JJong-03/face-tracking-robot-arm/assets/presentations/final/20251117_2ndSem_12week_presentation_final-presentation-system-overview.pdf

01

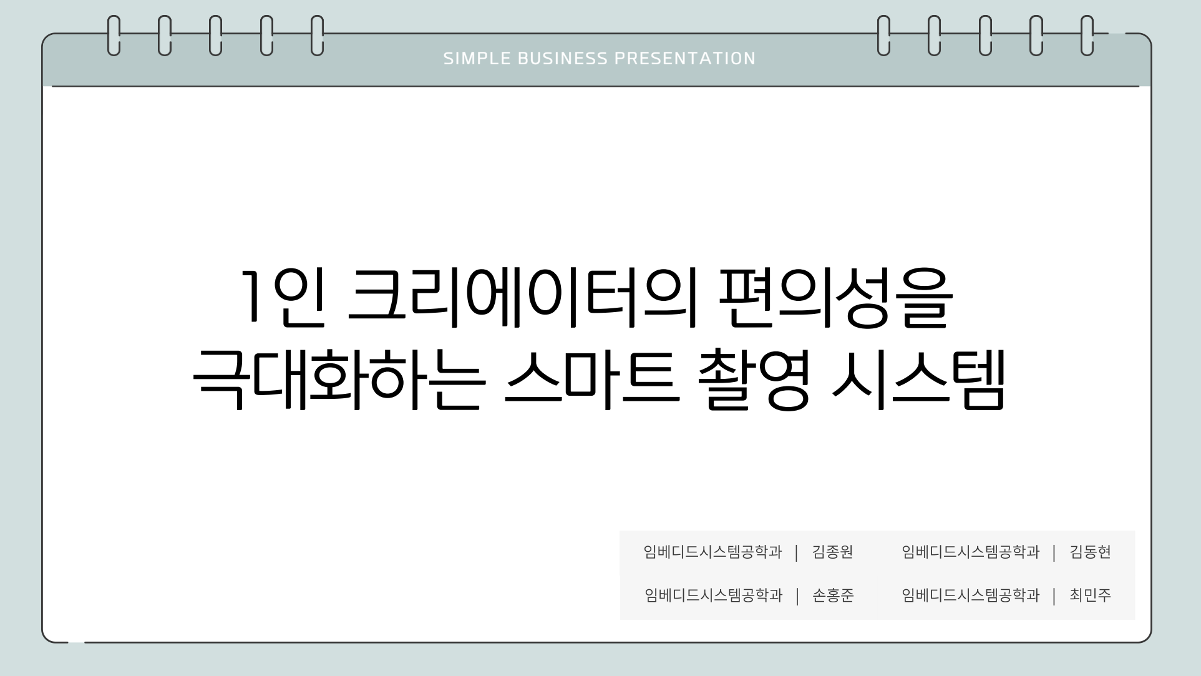
[picture p52: page 1]

임임임임임임임임임임 | | 임임임

# 1인 크리에이터의 편의성을 극대화하는 스마트 촬영 시스템

SIMPLE BUSINESS PRESENTATION

임임임임임임임임임임 | | 임임임
임임임임임임임임임임 | | 임임임 | 임임임임임임임임임임 | | 임임임

01

01

01 | 팀원 소개

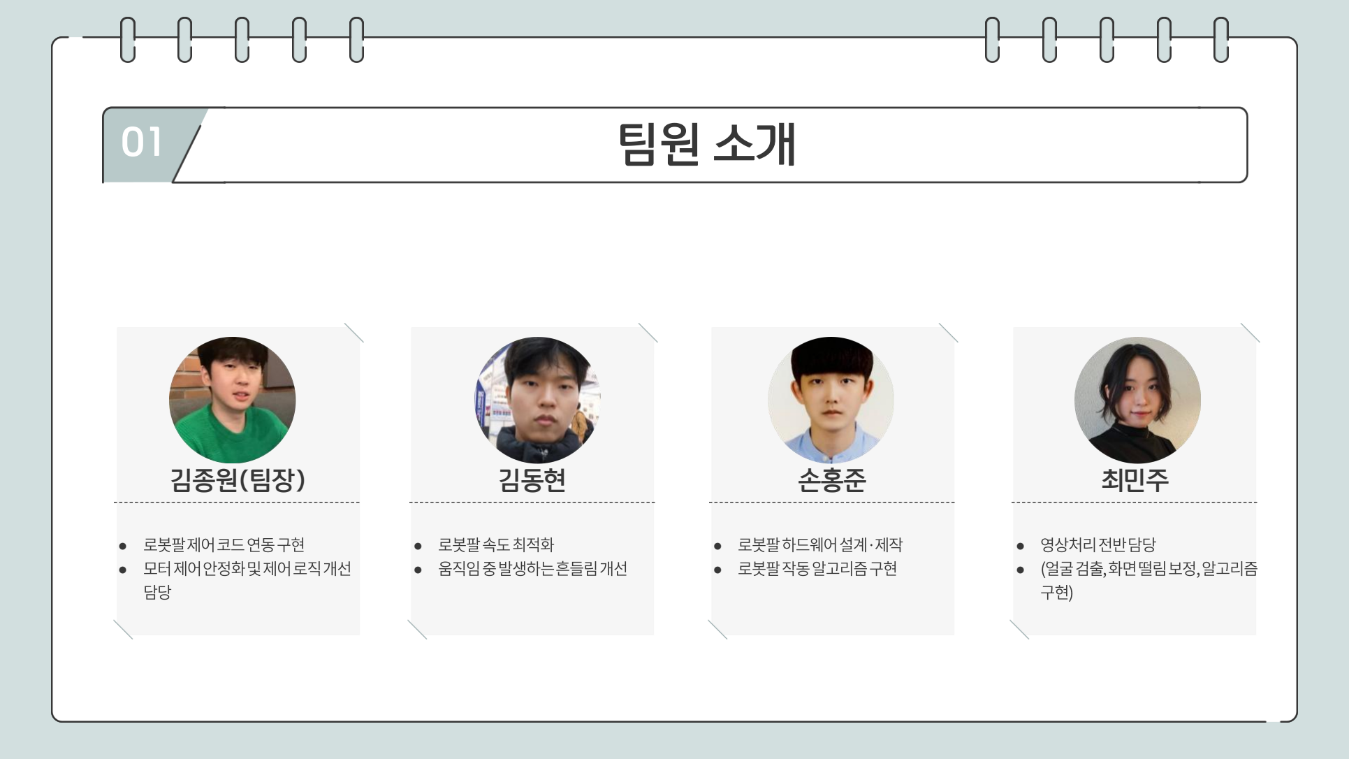
[picture p53: page 3]

- 임임임 | 임임 임임 임임 임임
- 임임 임임 임임임 | 임 임임 임임 임임
임임

## 김종원(팀장)

- 임임임 | 임임 임임임
- 임임임 | 임 임임임임 | 임임임 | 임임

## 김동현

- 임임임 | 임임임임 | 임임 · 임임
- 임임임 | 임임 임임임임 | 임임

## 손홍준

- 임임임임 임임 임임
- (임임 임임 , 임임 임임 임임 , 임임임임 임임 )

## 최민주

012 | 글로벌 크리에이터 경제 시장

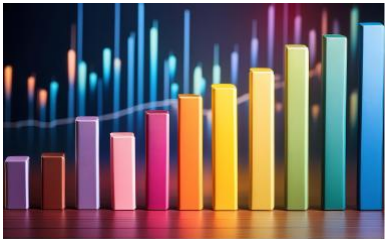
[picture p54: figure]
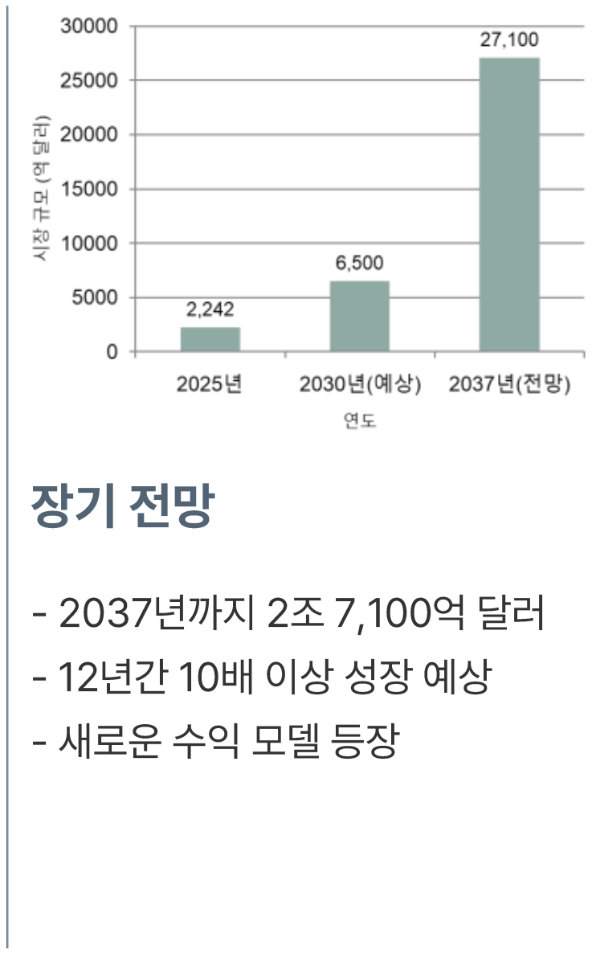
[picture p55: figure]
- 2037 임임임; - 임임임

- 임 2,242 임 임임
- 임임 임 268 임 임
- 임임임 | 임임임 | 임임

### 2025 임 임임 임임

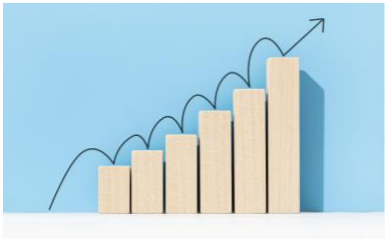
[picture p56: figure]

- 2024 임 임임 18.2% 임임
- 임임임임 | 임임임
- 임임임 | 임임임 | 임임 임임

### 임임임

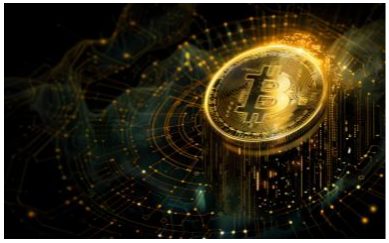
[picture p57: figure]

- CAGR 22.7%
- 임임 임임임 | 임임
- 임임임 | 임임 임임
- 임임 임임 임임

### 임임임 임임임

01

03 | Solution

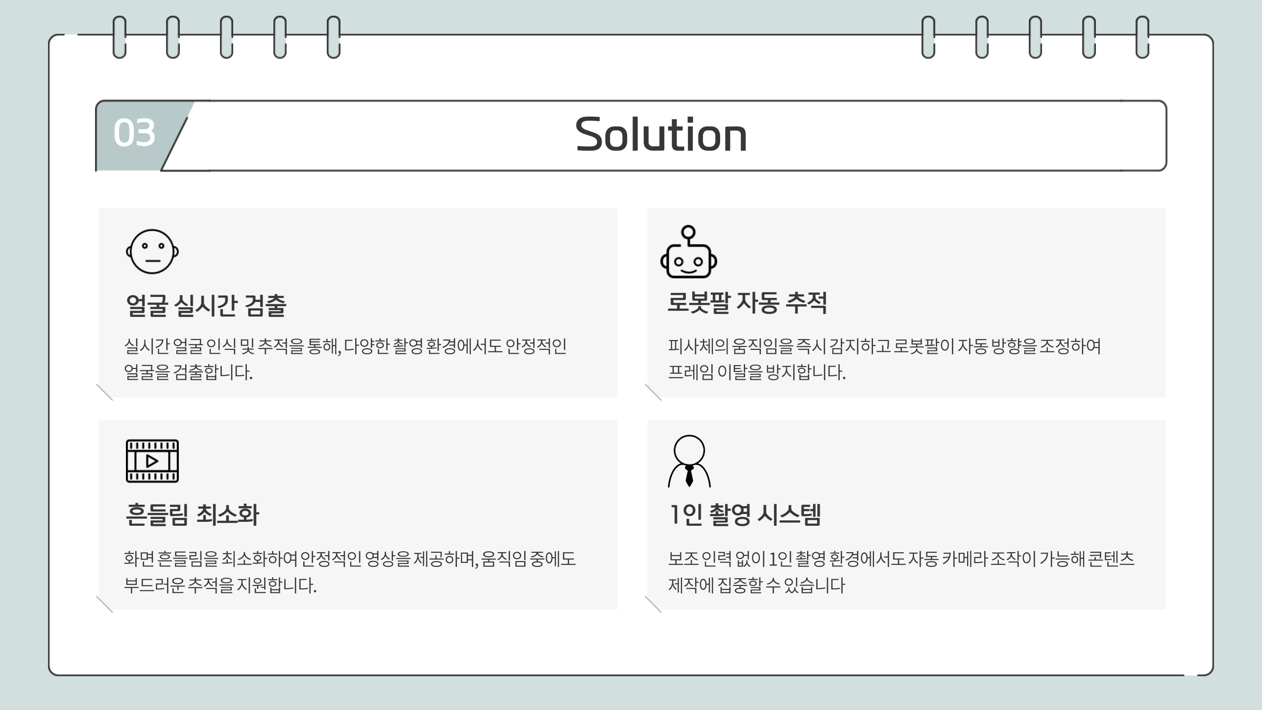
[picture p58: page 5]

임임 임임 임임 1임 임임 임임임임임 | 임임 임임임 | 임임임 | 임임임 | 임임임
임임임 | 임임임 | 임 임임임임

## 1인 촬영 시스템

임임 임임임임 | 임임임임임 | 임임임임 | 임임임 | 임임임임 | , 임임임 | 임임임
임임임임 | 임임임 | 임임임임임 | .

## 흔들림 최소화

임임임임 | 임임임임 | 임임 임임임임 | 임임임임 | 임임 임임임 | 임임임임
임임임 | 임임임 | 임임임임임 | .

## 로봇팔 자동 추적

임임임 | 임임 임임 임 임임임 | 임임 , 임임임 | 임임 임임임임임 | 임임임임
임임임 | 임임임임임 | .

## 얼굴 실시간 검출

04 | 기존의 제품과의 비교

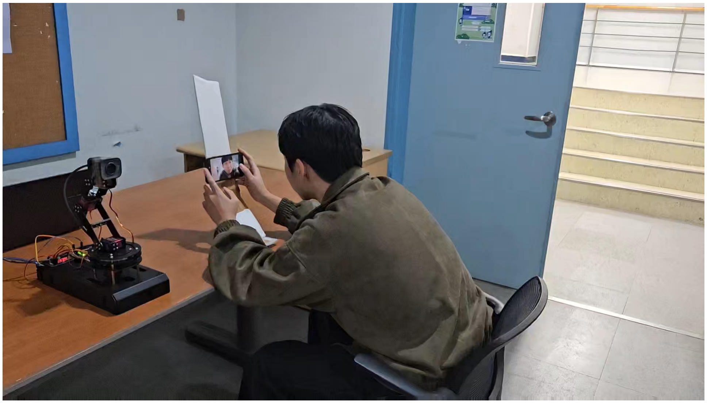
[picture p59: figure]

05 | 기존의 제품과의 비교

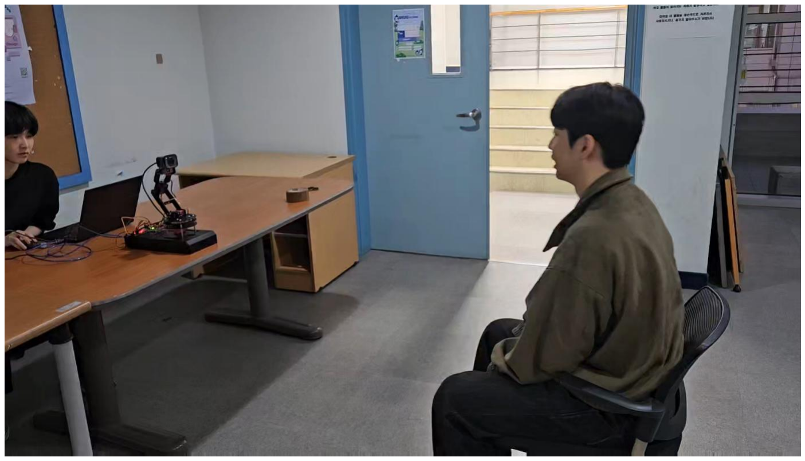
[picture p60: figure]
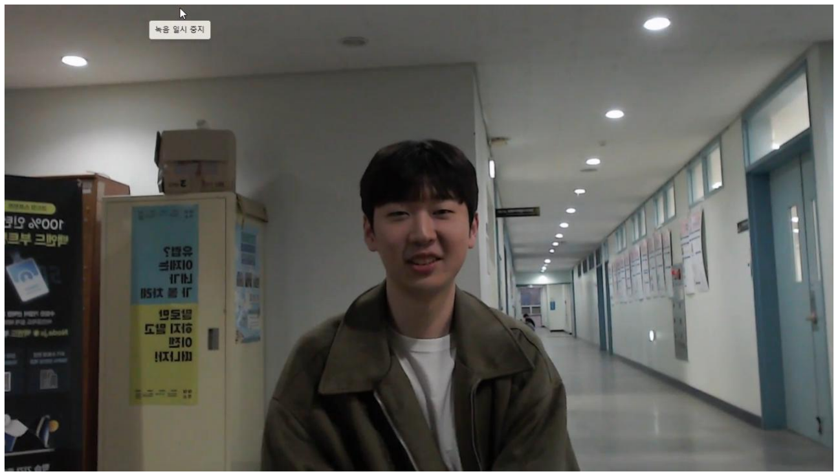
[picture p61: figure]

06 | 동작과정

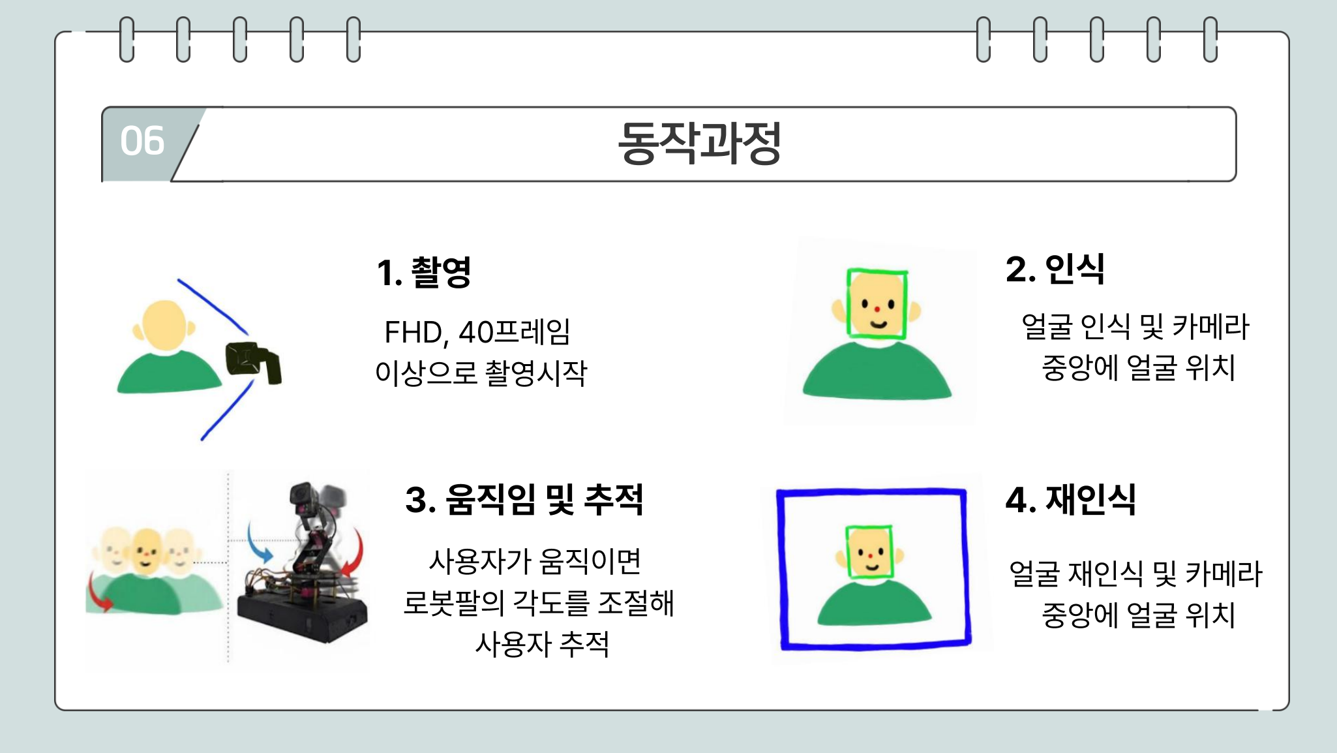
[picture p62: page 8]

1. 임임 | 2. 임임
3. 임임임 | 임 임임 | 4. 임임임

## FHD, 40 임임임 임임임임 임임임임

## 임임 임임 임 임임임

임임임 | 임임 임임
임임임임 | 임임임임
임임임임 | 임임임 | 임임임
임임임 | 임임
임임 임임임 | 임 임임임
임임임 | 임임 임임

07 | 기능 소개

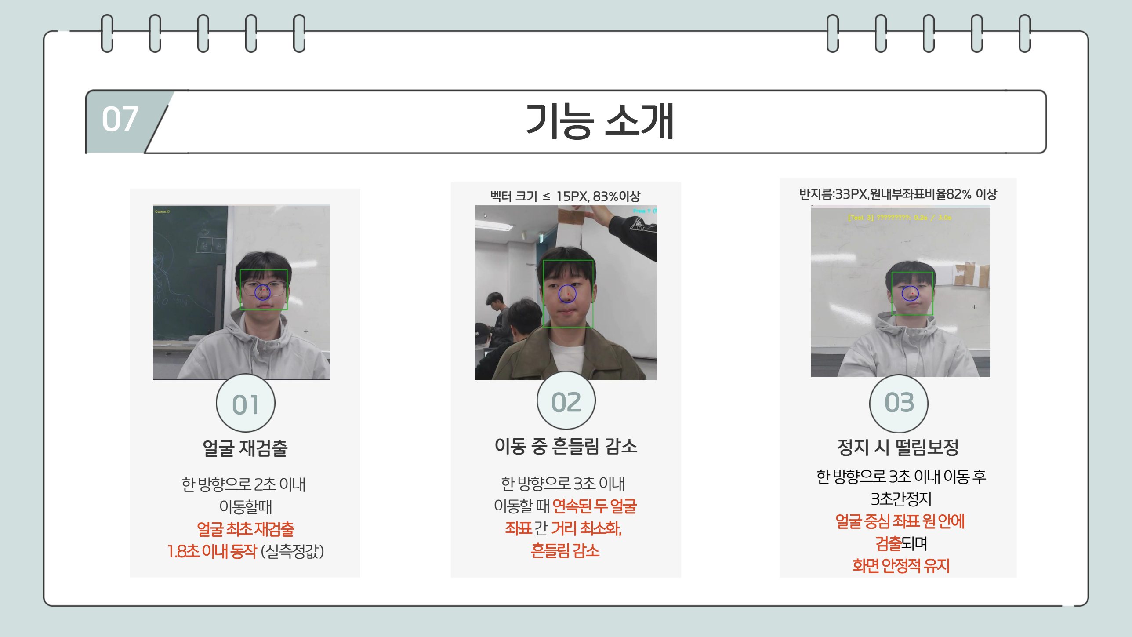
[picture p63: page 9]

한 방향으로3초 이내 이동 후
3초간정지
얼굴 중심 좌표 원 안에
검출되며
화면 안정적 유지

정지 시 떨림보정

한 방향으로3초 이내
이동할 때 연속된 두 얼굴
좌표간 거리 최소화,
흔들림 감소

이동 중 흔들림 감소

한 방향으로2초 이내
이동할때
얼굴 최초 재검출
1.8초 이내 동작(실측정값)

얼굴 재검출

벡터 크기 ≤ 15PX, 83%이상 | 반지름:33PX,원내부좌표비율82% 이상
01 | 02 | 03

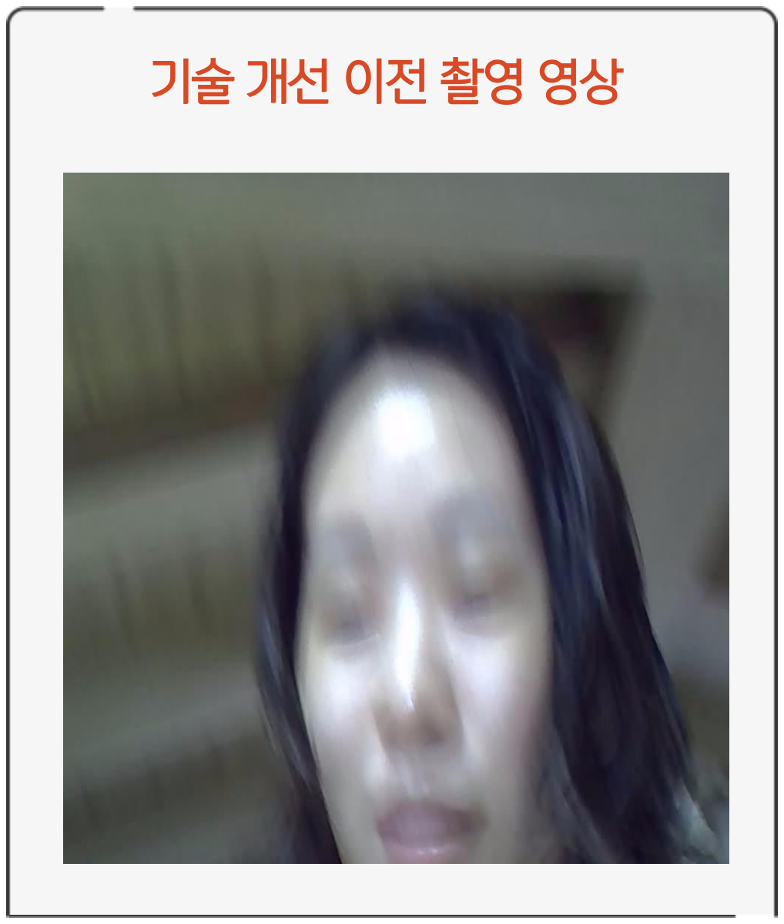
[picture p64: figure]

1. 하드웨어 구성

# 적용기술

SIMPLE BUSINESS PRESENTATION

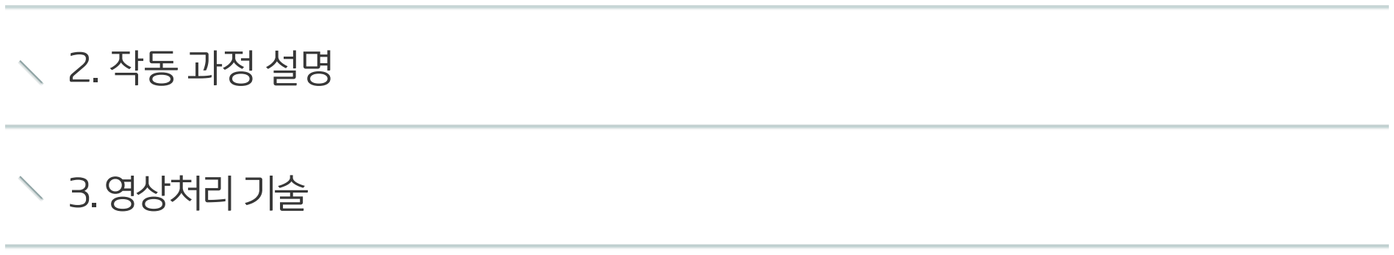
[picture p65: figure]
3. 영상처리 기술
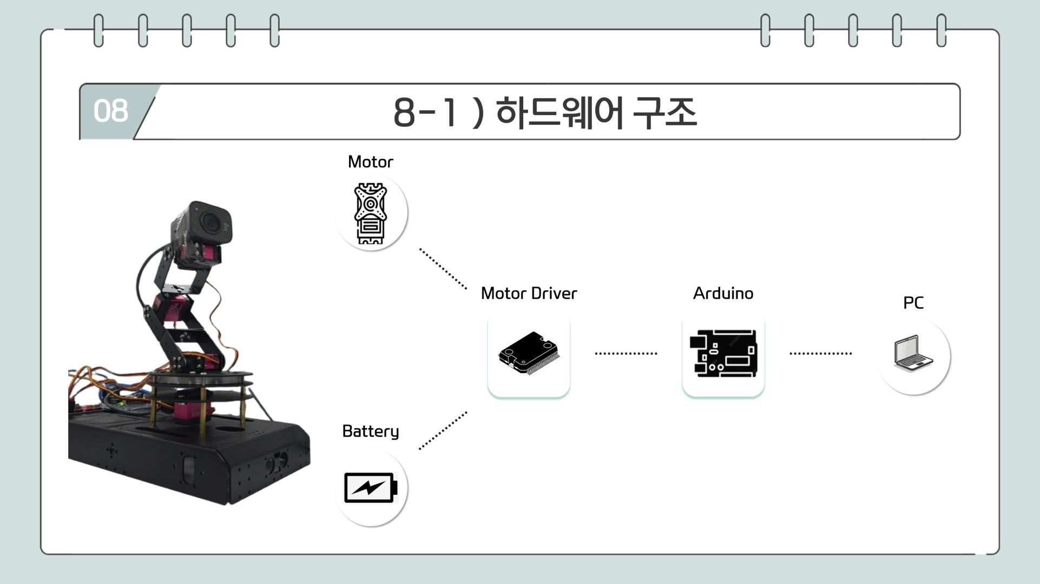
[picture p66: page 11]
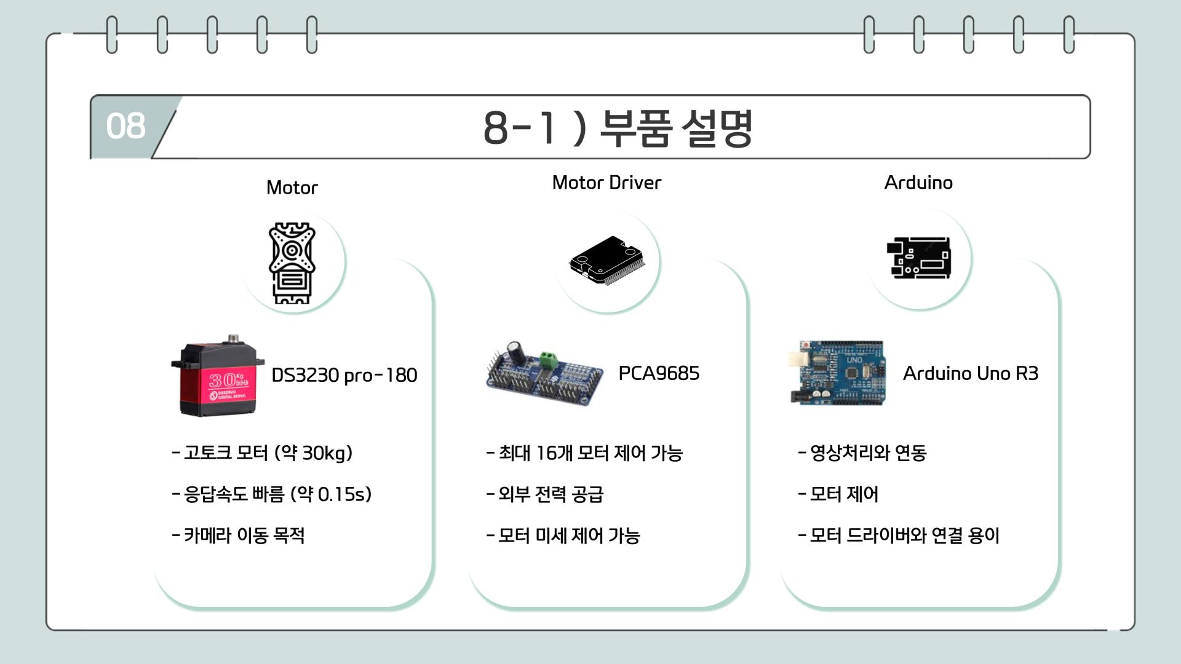
[picture p67: page 12]
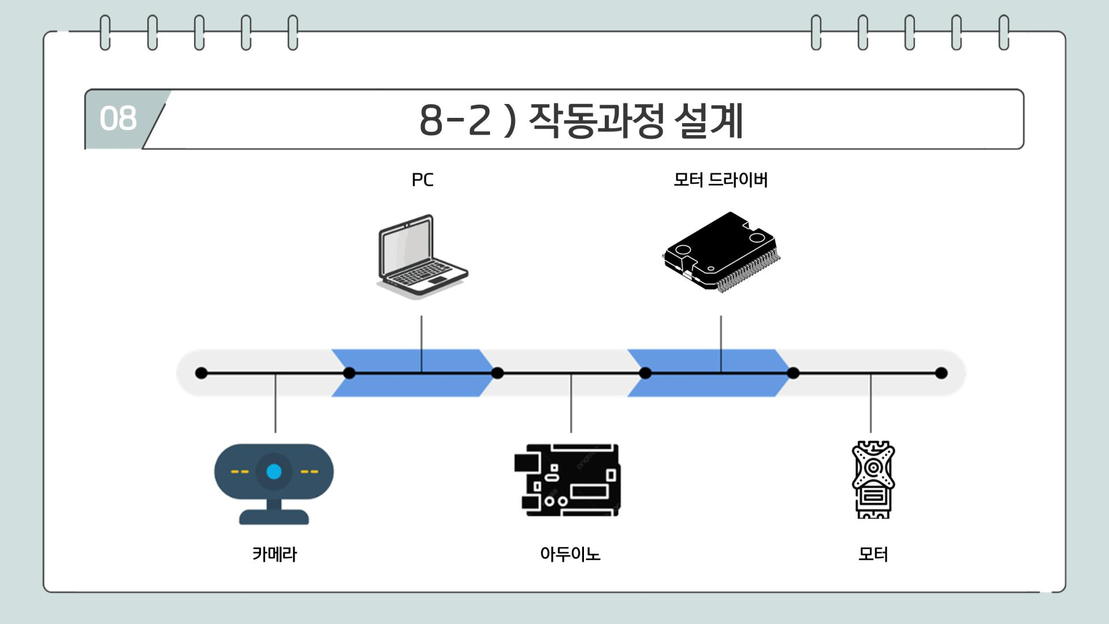
[picture p68: page 13]
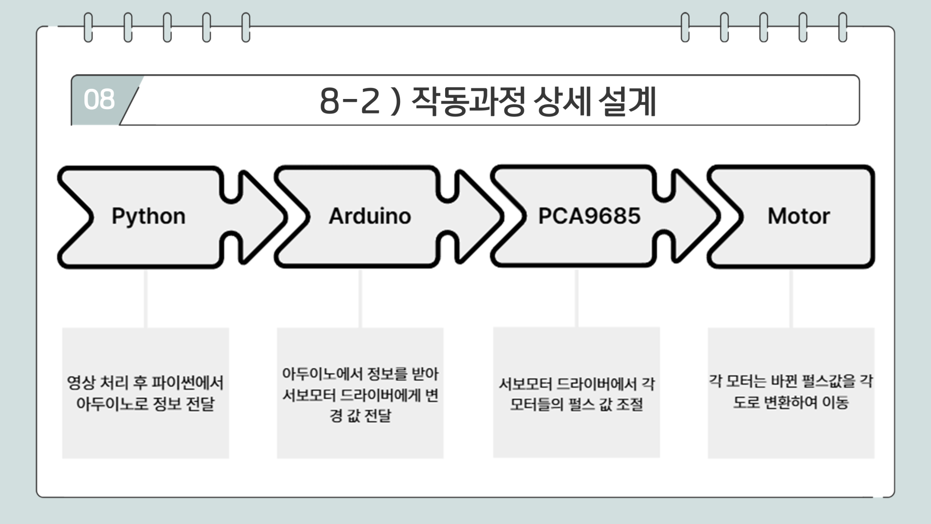
[picture p69: page 14]
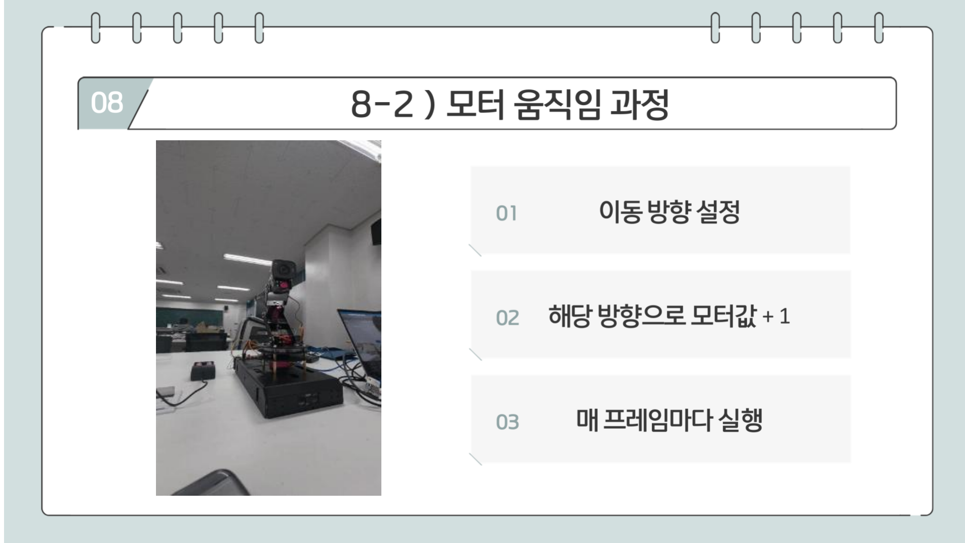
[picture p70: page 15]

08 | 8-3) 영상처리

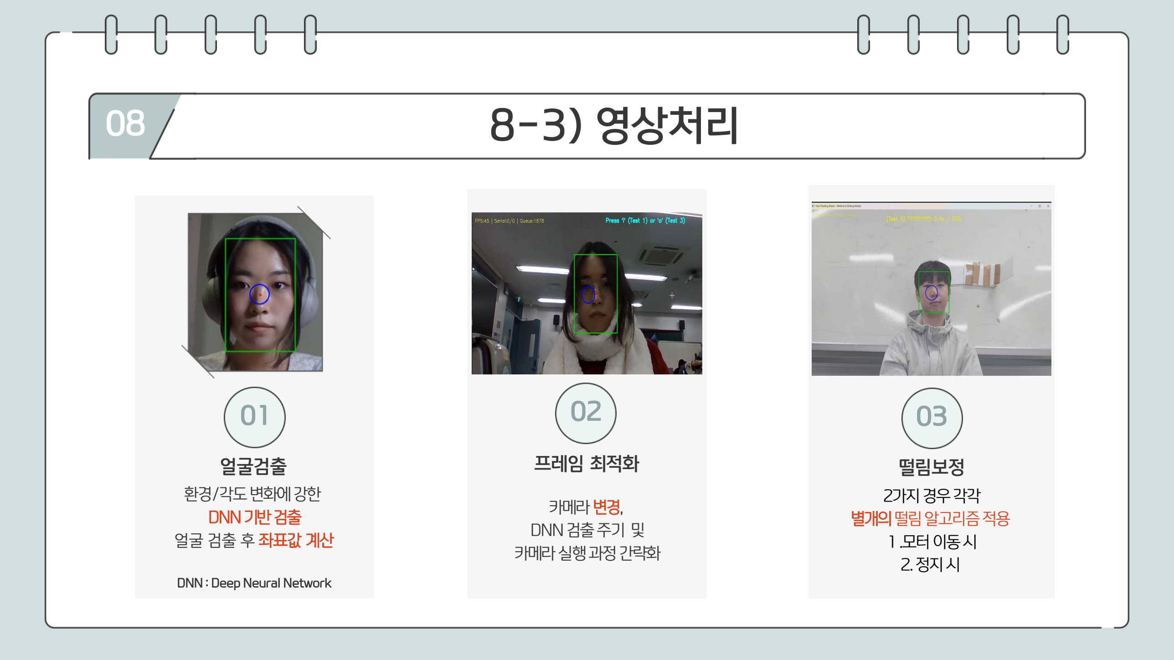
[picture p71: page 16]

2가지 경우 각각
별개의떨림 알고리즘 적용
1 .모터 이동 시
2. 정지 시

떨림보정

03

카메라 변경,
DNN 검출 주기 및
카메라 실행 과정 간략화

프레임 최적화

02

환경/각도 변화에 강한
DNN 기반 검출
얼굴 검출 후 좌표값 계산

DNN : Deep Neural Network

얼굴검출

01

09 | 시스템 도입 효과 요약

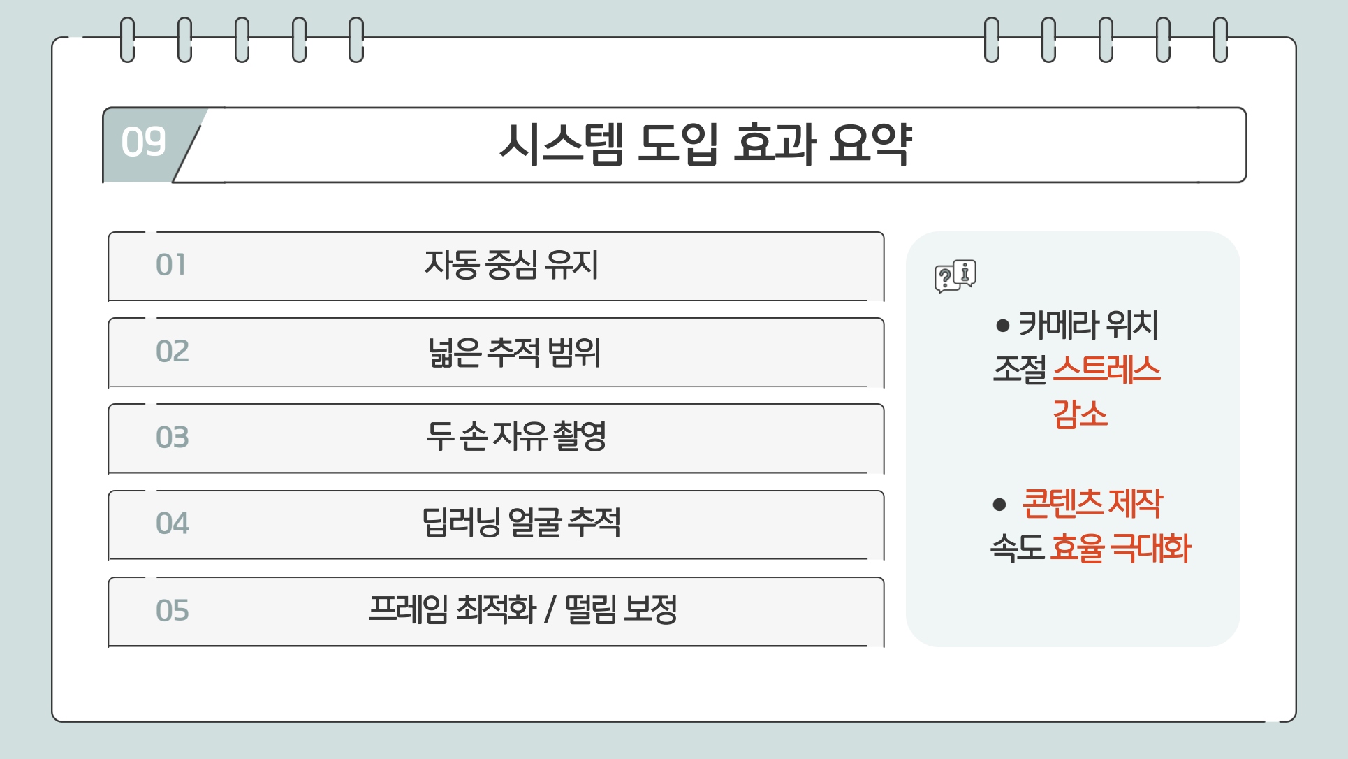
[picture p72: page 17]

## 프레임 최적화 / 떨림 보정

## 두 손 자유 촬영

05

04 | 딥러닝 얼굴 추적 넓은 추적 범위

03

## - 카메라 위치 조절 스트레스

감소

## - 콘텐츠 제작 속도 효율 극대화

02

01 | 자동 중심 유지

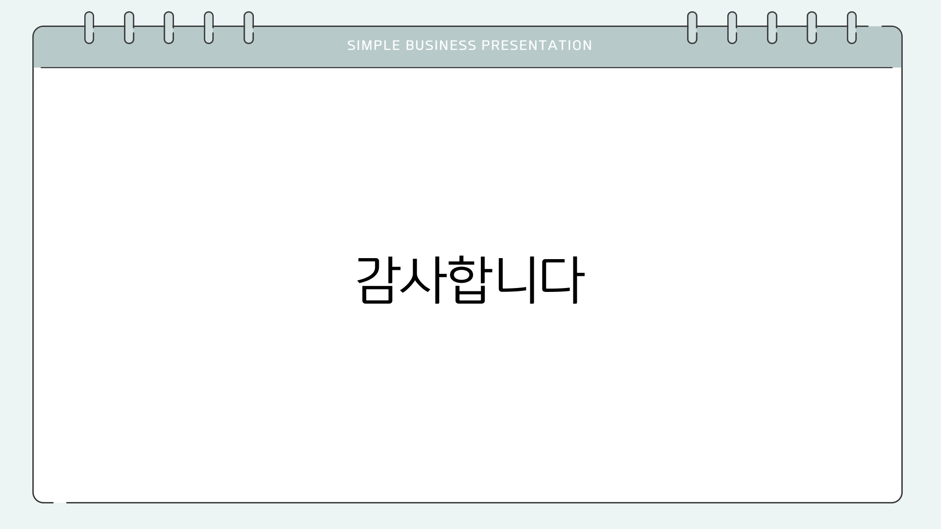
[picture p73: page 18]

# 감사합니다

SIMPLE BUSINESS PRESENTATION
