JJong-03/face-tracking-robot-arm/archive/weekly_notes/1st_semester/05week.md

# 회의 기록

## 회의 정보

- **일시**: 2025년 3월 31일, 4월 1일 
- **장소**: 온라인  
- **참석자**: 김종원, 김동현, 손홍준, 최민주  
- **회의 주제**: 개발 시 신경 써야할 부분 파악# 회의 기록

## 회의 정보

- **일시**: 2025년 3월 31일, 4월 1일 
- **장소**: 온라인  
- **참석자**: 김종원, 김동현, 손홍준, 최민주  
- **회의 주제**: 개발 시 신경 써야할 부분 파악
- **기록자**: 김종원

## 회의 내용

# 실시간 얼굴 추적 조명 & 카메라 제어 시스템

> 얼굴을 인식해 실시간으로 카메라와 조명을 자동 조정하는 스마트 촬영 시스템

---

## 1. 인식 기술 (AI Vision)

### 실시간 객체 탐지
- **기술:** YOLO (You Only Look Once), SSD 등
- **역할:** 얼굴을 포함한 객체를 빠르게 인식하고 좌표 추출

### 세분화 (Segmentation)
- **기술:** DeepLab, Mask R-CNN 등
- **역할:** 얼굴 영역을 정확히 분리하여 조명의 반사 위치나 조도 보정에 활용

### 딥러닝 구동 장치
- **기기:** NVIDIA Jetson (Nano, Xavier 등), Raspberry Pi (성능 한계 존재)
- **비고:** Jetson은 GPU 내장으로 AI 연산에 적합, Pi는 간단한 인식에는 충분

---

## 2. 조명 조정

### 조명 확산/집광 조절
- **화광 조절:** 조명의 광원 크기 변화, 확산 정도 조절 필요 (줌렌즈 혹은 모터 이용)
- **x, y, z축 모두 고려 필요:**
  - **x/y축:** 좌우 및 상하 조명 방향 이동
  - **z축:** 거리 조절 (예: 집광 시 거리를 좁힘, 확산 시 멀어짐)

### 거리 측정
- **방식 1: Stereo Camera (Depth Camera)**
  - 카메라 2개를 사용해 거리(Depth)를 계산
- **방식 2: 레이저 거리 측정 (ToF, LiDAR, 단방향 레이저)**
  - 정확한 거리 측정 가능, z축 제어에 효과적

---

## 3. 모터 및 구동 제어

### 모터 구성
- **모터드라이버 필요:** 일반 모터/스텝모터는 별도 전력 공급 필요 (서보보다 강력하지만 제어 복잡)
- **서보모터의 한계:** 작고 간단하나 추진력 부족, 무거운 장비 회전에 한계 있음

### 제어 흐름
- AI(딥러닝 인식)는 라즈베리 파이에서 실행
- 얼굴 좌표와 거리 정보만 아두이노에 전달 (Serial 통신: Tx, Rx)
- 아두이노는 모터 제어에 전념 → 서보모터 또는 스텝모터 구동

---

## 4. 시스템 구현 시 주요 고려사항

1. 조명과 카메라가 모두 회전해야 하므로 모터 토크가 충분한지 검토 필요
2. x, y, z 좌표를 고려한 조명 방향 및 초점 자동 제어
3. 모터는 별도 전력 필요 → 배터리 또는 어댑터 설계 필수
4. AI는 Raspberry Pi에서, 제어는 Arduino에서 분리 처리 → 병렬 동작 안정성 확보
