JJong-03/face-tracking-robot-arm/archive/weekly_notes/2nd_semester/04week.md

# 회의 기록

- 일시: 4주차
- 장소: 온라인, 오프라인
- 작성자: 김종원

## 참석자
- 김종원
- 김동현
- 손홍준
- 최민주

## 진행 내용
- 교수님 피드백 요청 사항 확인
- 피드백 반영하여 정량지표 1·2·3 문구 및 절차 수정
- 목표 수치 도해(그림) 추가: IFR10, ICR3

## 논의 내용
- 정량지표 1(FRT): 이동 **대각선(↖↘, ↗↙)** 포함. 수평 ±1.0 m, 수직 ±0.50 m, 대각선 경로 길이 ±0.70 m, 속도 **0.5 m/s**.
- 정량지표 2(IFR10): 사용자 **30 cm를 3 s(10 cm/s)** 이동, 프레임 간 벡터 \( d_t=\sqrt{(\Delta x)^2+(\Delta y)^2} \)의 **10 px 이하 비율** 평가.
- 정량지표 3(ICR3): **정지 전 30 cm·3 s(10 cm/s)** 이동으로 변경(2번과 일관). 정지 3 s 동안 첫 좌표 기준, **지름 = 가로 해상도의 n%** 원 내부 비율 평가.
- 결과 보고 시 방향/반복 횟수, 해상도·FPS, 실패 기준(연속 미검출 N프레임) 로그화.

## 최종 평가지표(수정안)

| 구분 | 측정 방법 | 목표 지표 |
|---|---|---|
| **평가지표 1. 얼굴 재인식 시간 (FRT)** | 얼굴이 **수평(±1.0 m)**, **수직(±0.50 m)**, **대각선(↖↘, ↗↙, 경로 길이 ±0.70 m)** 중 한 방향으로 **0.5 m/s** 등속 이동. 로봇팔이 추종하며 **이동 시작(또는 최초 미검출) → 재인식 첫 프레임**까지의 시간을 측정 | **≤ 2초** |
| **평가지표 2. 로봇팔 저속 추적 안정성 (IFR10)** | 사용자가 **30 cm를 3 s(10 cm/s)** 동안 단일 방향 이동. 매 프레임 얼굴 중심 \((x_t,y_t)\) 기록 → 연속 프레임 벡터 \(d_t=\sqrt{(\Delta x)^2+(\Delta y)^2}\) 계산 → \(d_t \le 10\) px 프레임 비율 산출 | **≥ 85%**<br>IFR10 목표 수치 예시 |
| **평가지표 3. 정지 고정 안정성 (ICR n%)** | (**정지 전**) 사용자 **30 cm·3 s(10 cm/s)** 이동 → (**정지 구간**) **3 s 정지**. 첫 좌표를 기준으로 **지름 = 프레임 가로의 n%**인 원을 그리고, 정지 구간 프레임들의 **원 내부 비율** 계산 | **원 내부 비율 ≥ 80%**<br>ICR 예시(3%로 시각화) |

## 기타 논의사항
- 로그 포맷(방향, 해상도, FPS, 반복 횟수, 실패 기준) 템플릿화하여 다음 버전에 반영

## 다음 회의
- Discord에서 일정 조율 후 공지
