JJong-03/face-tracking-robot-arm/archive/weekly_notes/1st_semester/01week.md

# 회의 내용 정리 보고서 (1차 + 2차 회의)

- **회의 일자**: 2025-03-06, 2025-03-08, 2025-03-09  
- **기록자**: 김종원  
- **회의 결과 및 결론 기록자**: 최민주

---

## 1. AI 기반 맞춤형 보조 기술 및 헬스케어

### 1-1. AI 기반 맞춤형 깔창 제작 (김종원)
- 개인의 **발 모양과 보행 패턴**을 분석하여 맞춤형 깔창 제작
- 보행 패턴 분석, 압력 분포 데이터 활용
- **재활 치료, 스포츠, 피트니스, 장시간 근무자** 등 다양한 활용 가능

### 1-2. AI 기반 실시간 청각 보조 시스템 (김종원)
- 주변 소리를 분석하여 **음성 → 문자 변환(STT)**, 난청인을 위한 보조 시스템
- **소음 필터링 AI** 적용으로 중요한 소리만 표시
- **Flutter 앱 연동** → 특정 상황에서 진동 또는 화면 알림 제공

### 1-3. AI 기반 개인 맞춤형 건강 관리 시스템 (김종원)
- **AI가 음식 & 운동 데이터 분석**, 맞춤형 식단 및 운동 추천 제공
- **카메라 + AI 데이터 분석**을 통한 자동 데이터 수집
- UWB 센서를 활용한 운동 자세 교정 기능 추가 가능

### 1-4. 스마트 깔창 – 보행 분석 및 피로도 측정 시스템 (최민주)
**핵심 기술**: ESP32, 압력 센서, IMU 센서, 블루투스

#### 필요성 및 활용 분야
- 잘못된 보행 습관 (안짱걸음, 팔자걸음 등) 분석 → 무릎 관절염, 허리 통증 예방
- 재활 치료 보조: 발목, 무릎, 고관절 수술 환자의 보행 데이터 제공
- 스포츠 & 피트니스: 운동선수 및 러너의 보행 및 압력 균형 분석, 부상 방지
- 장시간 서 있는 직업군 (간호사, 판매원 등) 피로도 관리 → 일정 이상 비정상적인 압력 변화 시 **진동 경고**

#### 주요 기능
- **보행 패턴 분석** – 압력 센서 + IMU 센서로 걸음 습관 분석 및 잘못된 보행 감지
- **피로도 측정 & 경고** – 일정 시간 이상 비정상적인 보행 시 진동 알림 제공
- **스마트폰 연동** – 걸음 수, 발바닥 압력 데이터 기록 → 물리치료 및 재활 분석 가능

**추가 아이디어**
- 온열 기능 추가 → 혈액순환 촉진 (추운 날씨 활용)
- GPS 연동 → 이동 경로 및 보행 거리 기록
- AI 학습을 통한 사용자별 보행 분석 모델 생성

---

## 2. 스마트 내비게이션 & 교통 보조 기술

### 2-1. 공간 기억 AI – 스마트 내비게이션 (김종원)
- 사용자의 **이동 패턴을 학습**하여 최적 경로 추천
- **UWB 센서**를 활용하여 GPS 신호가 약한 실내에서도 정밀한 위치 탐색 가능
- 위험 구간 자동 감지 및 경고 기능 포함

### 2-2. 음파 지도 – 시각 장애인을 위한 스마트 맵 (김종원)
- 초음파 센서 기반으로 장애물 감지 및 회피 안내 제공
- 방향별 음파 알림 (예: 오른쪽 장애물 → 왼쪽 귀에서 소리 발생)
- AI 학습을 통해 사용자 이동 경로 최적화

### 2-3. 사거리 신호 우선 판단 시스템 (손홍준)
- 차량 및 보행자 실시간 감지 후 교통 신호 자동 최적화
- 긴급 차량 우선 신호 제공, 보행자 신호 자동 조정
- 교통 흐름 분석을 통한 가변 신호 시간 조절

### 2-4. 주차장 현황 표시 앱 (손홍준)
- IoT 센서를 활용한 주차 공간 실시간 모니터링
- 주차장 지도 제공 → 빈자리 & 차 있는 자리 색상 구분
- 주차 공간 부족 시 자동 경고 시스템

---

## 3. AI 기반 취업 지원 및 학습 시스템

### 3-1. AI 기반 맞춤 취업 지원 & 강의 추천 서비스 (김동현)
- 사용자의 **기술 스택 & 포트폴리오 분석** 후 부족한 부분 보완 강의 추천
- 구직 공고 크롤링 (잡코리아, 원티드 등) → 최신 채용 트렌드 분석
- AI 기반 코드 분석, 이력서 피드백, 추천 강의 매칭 기능 포함

---

## 4. 스마트 생활 & 안전 보조 기술

### 4-1. 스마트 경사로 계단 – 자동 변형 계단 (최민주)
- 보행자 접근 시 센서 감지 → 계단 ↔ 경사로 변환
- IoT 원격 제어로 앱에서 조작 가능
- 안전 센서 탑재, 압력 감지로 오작동 방지

### 4-2. 스마트 헬멧 – 라이더 안전 시스템 (최민주)
- 충격 감지 후 자동 긴급 연락 전송
- 야간 감지 LED 라이트 기능 추가
- 후방 차량 감지 경고 시스템 적용

### 4-3. 스마트 무드 조명 (최민주)
- AI가 표정·음성 분석 후 감정에 맞는 조명 색상 자동 변경
- 리듬 싱크 기능 → 음악 비트에 따라 LED 패턴 변화
- 수면 모드 & 기상 모드 지원

---

## 5. 회의 결과 및 결론

**최종 선정된 4가지 주제**
1. AI 기반 실시간 청각 보조 시스템  
2. AI 기반 맞춤 취업 지원 & 강의 추천 서비스  
3. 스마트 도로 – AI 기반 교통 최적화 시스템  
4. 스마트 깔창 – 보행 분석 및 자세 교정 시스템

**다음 단계**:
- 각자 선정된 주제에 대한 평가지표를 작성하여 검토하기로 결정
