JJong-03/face-tracking-robot-arm/archive/weekly_notes/1st_semester/02week.md

# 회의 내용 정리 보고서 - 2주차

- **회의 일자**: 2025-03-12, 2025-03-13, 2025-03-14  
- **기록자**: 김종원

---

## 프로젝트 개요 - 최종 선택: 스마트 조명 & 촬영 보조 로봇

### 주요 기능

#### 자동 조명 조절
- 사물 인식(밝기 정도)을 통해 밝기 자동 조정 (어두우면 조명의 밝기를 더 밝게 조절)
- 주변 환경(빛) 분석 후 최적의 조명 세팅 적용

#### 카메라 & 조명 위치 자동 조정
- 사용자의 움직임을 따라 조명이 자동으로 회전
- 카메라 각도를 실시간으로 조정하여 최적의 촬영 구도 제공

#### 음성 & 제스처 컨트롤
- 음성 명령: 손벽을 치면 5초 뒤(조절 가능) 촬영 시작

---

## 추가 아이디어

### 1. AI 기반 초개인화 맞춤형 향기 생성기

#### 문제점
- 기존 향수는 사용자가 직접 선택해야 함
- 감정 & 호르몬 변화에 따라 최적의 향기를 자동 조절하는 시스템 없음
- 스트레스 상태에서 향기를 통해 긴장을 완화하는 맞춤 솔루션 부족

#### 해결책
- AI가 사용자의 기분(음성, 표정, 생체 신호 분석) → 맞춤형 향기 조합 생성
- 스트레스 상태면 라벤더 계열, 집중이 필요하면 로즈마리 계열 자동 추천
- 사용자 상태 변화에 따라 향기 농도를 실시간 조절
- 외출할 때 자동으로 향수 분사 또는 집안 환경에 맞춰 향기 변경
- 사용자가 직접 특정 상황 등록 가능 (예: "출근 전에는 상쾌한 향기, 취침 전에는 릴랙싱 향기")

#### 사용 기술
- 생체 데이터 분석 (Wearable Device + AI 표정 분석)
- 맞춤형 향기 조합 생성 (전자동 향기 디퓨저 + AI 조합 알고리즘)
- 스마트폰 & 스마트홈 IoT 연동

---

### 2. 향기 자동 조절 기능이 있는 스마트 옷장

#### 문제점
- 기존 옷장은 단순 보관만 가능하고 향기 유지 기능 없음
- 장마철 습기로 인해 옷에서 곰팡이 냄새 발생 가능

#### 해결책
- 옷장의 내부 습도와 온도를 감지하여 적절한 향기를 자동 분사
- 장마철에는 곰팡이 방지 향기, 외출 전에는 사용자가 선택한 향기 제공
- 향기 지속 시간을 스마트폰 앱에서 조절 가능

---

### 3. 스마트 향기 신발장 (발 냄새 자동 제거 + 향기 추가)

#### 문제점
- 기존 신발장은 보관 기능만 있고 냄새 제거 기능 부족
- 운동화, 구두 등 다양한 신발의 특성에 맞춘 향기 케어 필요

#### 해결책
- 악취 센서를 활용하여 신발 냄새 제거 (자연 탈취 + 향기 추가)
- 운동화에는 상쾌한 향, 구두에는 은은한 우디 향 자동 분사
- 신발 건조 기능 추가하여 여름철 땀 관리 가능
- 날씨에 따라 신발 추천 기능 (예: 비 오는 날 방수 신발 추천)

---

### 4. 스마트 카트 (장보기 도우미 & 자동 결제)

#### 문제점
- 마트에서 장볼 때 상품을 하나씩 검색해야 하는 불편함
- 계산대에서 줄 서서 결제하는 과정이 번거로움

#### 해결책
- 카트에 RFID 태그 리더기 장착하여 제품 자동 인식
- 카트 안에서 바로 결제 가능 → 계산대에서 줄 설 필요 없음
- AI가 할인 정보 & 추천 상품 제공

#### 차별점
- 기존 마트는 바코드를 일일이 찍어야 하지만, 이 카트는 자동으로 상품을 인식
- AI가 현재 담긴 상품을 분석해 할인 정보 & 대체 상품 추천
- "이 제품보다 20% 더 저렴한 대체 상품이 있어요!"
- 사용자 쇼핑 패턴을 분석하여 개인 맞춤 추천 제공
