JJong-03/face-tracking-robot-arm/archive/weekly_notes/1st_semester/03week.md

# 회의 기록 & 시나리오 정리

## 회의 정보

- **일시**: 2025년 3월 17일, 18일, 23일  
- **장소**: 온라인  
- **참석자**: 김종원, 김동현, 손홍준, 최민주  
- **회의 주제**: 아이디어 관련 시나리오 세부 작성 및 요구사항 분석, 기능 정의 작성  
- **기록자**: 김종원

---

## 회의 내용

### ● 아이디어 관련 시나리오 세부 작성 (통과된 시나리오)
- 자동 조명 조절 기능  
- 카메라 & 조명 위치 자동 조정 기능  
- 손뼉을 이용한 촬영 시작 기능

### ● 요구사항 분석 (2단계) 및 기능 정의 (3단계) 작성

---

## 시나리오 작성

### 1. 조명 밝기 조절 (웹 or 앱을 통해 미리 설정)

#### 1번 시나리오

- 스마트 조명 앱을 통해 촬영 조명 밝기 프리셋(저장된 설정값)을 미리 설정한다.
- 촬영 중인 영상의 밝기를 측정하여, 설정한 프리셋과 동일한 밝기가 유지되도록 조명의 밝기를 자동 조절한다.
- 사용자는 촬영 중 앱을 통해 실시간으로 조명을 조정할 수 있다.

##### 예제

유튜버 A는 밝기가 다른 두 환경에서 일정한 밝기로 촬영하고 싶어 한다.  
현재 어두운 환경에서는 영상이 너무 어둡고, 밝은 환경에서는 과도하게 밝아지는 문제가 있다.  
→ 이를 해결하기 위해 어두운 환경에서는 조명의 밝기를 자동으로 높이고, 밝은 환경에서는 낮춰 영상에서 항상 균일한 밝기를 유지한다.  
또한, 사용자가 앱을 통해 실시간으로 밝기를 직접 조절할 수 있는 기능도 제공한다.

---

### 2. 카메라 & 조명 위치 자동 조정 기능

#### 2번 시나리오

- 카메라는 촬영 대상자의 얼굴을 피사체로 인식한다.
- 조명은 카메라에 부착되어 피사체가 있는 방향을 자동으로 비춘다.
- 카메라는 피사체의 움직임을 실시간으로 따라 이동하여 항상 프레임 중앙에 위치하도록 조정한다.
- 조명도 카메라 움직임에 맞춰 자동으로 각도를 조정하여 균일한 조명 환경을 유지한다.

##### 예제

온라인 강사 B는 촬영 중 자유롭게 움직이며 강의를 진행하고 싶어 한다.  
그러나 일반 카메라로 촬영하면 사용자를 항상 중심에 오도록 하지 못 하고, 조명의 각도도 일정하지 않아 안정적인 촬영이 어렵다.  
→ 이를 해결하기 위해 카메라와 조명이 사용자를 자동으로 인식하고, 움직임을 따라 각도를 조정하도록 한다.

---

### 3. 손뼉을 이용한 촬영 시작 기능

#### 3번 시나리오

- 사용자가 일정 거리 뒤에서 손뼉을 치면, 음성 센서가 소리를 감지한다.
- 촬영이 자동으로 시작되도록 설정하여, 카메라까지 이동하는 번거로움을 해결한다.

##### 예제

개인 유튜버 C는 카메라를 특정 위치에 설정한 후, 일정 거리 뒤에서 촬영을 시작하고 싶어 한다.  
그러나 촬영을 시작할 때마다 카메라까지 이동하여 조작한 후 다시 촬영 위치로 돌아오는 과정이 번거롭다.  
→ 이를 해결하기 위해 사용자가 일정 거리 뒤에서 손뼉을 치면 일정 시간 후 자동으로 촬영이 시작되도록 한다.

---

## 요약

이 기능들을 통해 촬영자는  
- 조명을 미리 설정하고, 촬영 중 자동으로 조정되며  
- 카메라와 조명이 실시간으로 움직임을 추적하여  
**최적의 촬영 환경을 제공**받을 수 있다.
