JJong-03/face-tracking-robot-arm/archive/weekly_notes/1st_semester/04week.md

# 회의 기록 & 요구사항 및 기능정의 수정

## 회의 정보

- **일시**: 2025년 3월 29일, 30일
- **장소**: 온라인  
- **참석자**: 김종원, 김동현, 손홍준, 최민주  
- **회의 주제**: 아이디어 관련 시나리오 세부 작성 및 요구사항 분석, 기능 정의 작성  
- **기록자**: 김종원

---
## 요구사항 및 기능정의

## 1. 카메라 & 조명 위치 자동 조정

### 요구사항 1

**"촬영 중, 움직여도 얼굴이 너무 왼쪽이나 오른쪽으로 치우쳐 화면 바깥으로 나가지 않도록 촬영 화면 안에 유지되었으면 좋겠어"**

→ **해결 방법**: 얼굴을 인식해서 카메라와 조명이 얼굴을 추적하도록 카메라&조명 지지대의 각도를 조절

- **Deadline**: 5월 25일  
- **기능 정의**: 카메라 & 조명 얼굴 추적  
- **설명**: 카메라와 조명이 자동으로 얼굴 중심 방향을 따라가도록 각도 조절

### 요구사항 2

**"촬영 중, 카메라나 조명에서 내가 멀어지거나 가까워졌을 때도 내 얼굴이 일정한 크기로 유지되면 좋겠어"**

→ **해결 방법**: 얼굴 크기가 일정하게 유지되도록 거리 측정 및 카메라/조명 각도 자동 조절

- **Deadline**: 5월 25일  
- **기능 정의**: 카메라 & 조명과 얼굴 사이 거리 조절  
- **설명**: 사용자와의 거리 20cm 이내를 유지하도록 카메라 각도 조절

### 요구사항 3

**"기존 조명은 단순히 켜거나 끄는 기능만 있어서 불편해. 밝기를 단계별로 조절할 수 있으면 좋겠어"**

→ **해결 방법**: 음성 명령 기반의 5단계 밝기 조절 기능 구현

- **Deadline**: 4월 28일  
- **기능 정의**: 음성 명령 기반 단계별 밝기 조절  
- **세부사항**:
    - 음성 명령어: "1단계", "2단계", ..., "5단계"
    - 밝기 범위: 100 ~ 700 lux
    - 음성 인식 조건: 20cm 이내, 50db 이상

---

## 2. 소리로 촬영 컨트롤

### 요구사항 1

**"카메라와의 거리가 멀어 조작이 번거로워. 음성으로 촬영을 시작하고 종료하고 싶어"**

→ **해결 방법**: 음성 인식을 통해 촬영 시작/종료

- **Deadline**: 4월 28일  
- **기능 정의**: 음성을 통한 영상 촬영 기능  
- **명령어**: "영상 촬영 시작", "영상 촬영 종료"

### 요구사항 2

**"촬영 타이머도 음성으로 설정하고 싶어"**

→ **해결 방법**: 음성으로 타이머 기능을 실행

- **Deadline**: 5월 10일  
- **기능 정의**: 음성을 통한 영상 촬영 타이머 기능  
- **명령어**: "n초 뒤 영상 촬영 시작"

### 요구사항 3

**"이미지 촬영 모드를 연속으로 바꾸고 싶어. 음성으로 가능했으면 좋겠어"**

→ **해결 방법**: 음성으로 이미지 촬영 모드 설정

- **Deadline**: 5월 10일  
- **기능 정의**: 음성을 통한 이미지 촬영 횟수 변경 기능  
- **명령어**: "n장 촬영 시작" (1~10장, 0.5초 간격, 2초 뒤 시작)
