JJong-03/face-tracking-robot-arm/archive/weekly_notes/2nd_semester/01week.md

# 회의 기록

**일시**: 2025-09-07 17:00 ~ 17:30  
**장소**: Discord 온라인 회의  
**작성자**: 김종원  

---

## 참석자
- 김종원  
- 김동현  
- 손홍준  
- 최민주  
- 이채은  

---

## 진행 내용
1. 물건 구입 정리  
2. 평가표 수정  

---

## 논의 내용
### 1: 물건 구입 정리
- 필요한 물품 목록을 확인하고 구입 계획을 점검  

### 2: 평가표 수정
- 로봇팔 얼굴 추적 시스템의 성능 평가 지표를 구체화  

---

## 평가 지표 정리

| 구분 | 측정 방법 | 목표 지표 |
|---|---|---|
| 평가지표 1 | 얼굴이 좌우로 1m, 위아래로 50cm를 3초 동안 움직였을 때 로봇팔이 몇 초 이내에 따라잡는가 | 3초 이내 |
| 평가지표 2 | 사용자가 화면 밖으로 나갔을 때, 이동 방향(좌·우·상·하)으로 로봇팔이 움직이는 확률 | 5번 시도 중 80% 이상 |
| 평가지표 3 | 사용자가 움직인 뒤, 로봇팔이 얼굴을 추적한 상태에서 10초간 매초 인식된 얼굴 좌표와 기준 좌표의 오차율 | 10개 중 80% 이상이 오차 5% 이내여야 함 |

---

## 기타 논의사항 / 다음 회의
- 다음 회의 일정은 필요 시 Discord에서 추후 조율
