JJong-03/face-tracking-robot-arm/archive/weekly_notes/2nd_semester/02week.md

# 회의 기록  
**일시:** 2025-09-10 18:10 ~ 19:10, 2025-09-11 12:00 ~ 13:30  
**장소:** 오프라인, 온라인  
**작성자:** 김종원

---

## 참석자
- 김종원
- 김동현  
- 손홍준  
- 최민주  
- 이채은  

---

## 진행 내용
- 교수님 피드백 공유  
- 평가지표 수정 회의  

---

## 논의 내용
### 1. 교수님 피드백 요약
1. 사용자 이동속도 기술을 명시할 것  
2. 기존 2번 평가지표는 1번과 유사하니, 다른 평가지표로 대체할 것  
3. 평가지표의 내용은 괜찮지만, 값들을 좀 더 도전적으로 수정할 것  

---

### 2. 아이디어 정리
#### [아이디어 1]  
- 유튜브 쇼츠 형식 (10초 내외) 영상 5개 촬영  
- 해당 영상 기반 설문조사 진행  
  - 예: 화면 흔들림이나 거슬림 여부  
  - 응답 예시  
    1. 매우 그렇다  
    2. 약간 그렇다  
    3. 그렇다  
    4. 그렇지 않다  
    5. 전혀 그렇지 않다  
- 목표: 4점 이상 평균 획득  

#### [아이디어 2]  
- **MOS (Mean Opinion Score)** 도입  
  - 실제 영상/음성 품질 평가에 널리 활용되는 방식  
- 활용 방안  
  - 영상 속 객체 인식 품질 점수  
  - 촬영 중 사용자가 멀미를 느꼈는지 여부  
  - 촬영 영상 시청 시 화면 흔들림 체감 정도  

#### [아이디어 3]  
- 음성 명령 인식 테스트  
- 명령어: “촬영”  
- 환경 소음 조건 설정 (자동차 경적, 대화, 청소기, 발소리 등)  
  - 각 소음은 미리 정해둔 데시벨(dB) 기준 적용  
- 목표: 10번 중 8번 이상 정상 인식  

---

### 3. 최종 평가지표 (수정안)
**평가 지표 정리**

| 구분 | 측정 방법 | 목표 지표 |
|---|---|---|
| 평가지표 1  | 얼굴이 좌우(1m), 상하(50cm) 중 한 방향으로 **초속 0.5m**로 이동 시, 로봇팔이 다시 얼굴을 인식하는 시간 | 2초 이내 |
| 평가지표 2  | 다양한 환경(10초 영상 촬영)에서 **MOS 기반 설문** 및 화면 흔들림/멀미 체감 평가 | 평균 4점 이상 |
| 평가지표 3  | 얼굴 좌표 추적 시, 지름 **18px 원 범위** 내 좌표 비율 (사용자 정지 상태 1분 측정) | 80% 이상 |

---

## 기타 논의사항 / 다음 회의
- 음성 명령어 테스트를 별도 회차에서 실험 후 보완 검토  
- 다음 회의 일정은 필요 시 Discord에서 추후 조율
