JJong-03/face-tracking-robot-arm/archive/weekly_notes/2nd_semester/03week.md

### 회의 기록
- **일시:** 2025-09-16 22:10 ~ 23:30, 2025-09-17 18:00 ~ 19:30
- **장소:** 오프라인, 온라인
- **작성자:** 김종원

---

### 참석자
- 김종원
- 김동현
- 손홍준
- 최민주

---

### 진행 내용
- 교수님 피드백 공유
- 평가지표 수정 회의

---

### 논의 내용

#### 1) 교수님 피드백 요약
- 사용자 **이동 속도**를 명시할 것
- 기존 2번 평가지표는 1번과 유사하므로 **로봇팔 이동 시 흔들림 방지** 관점으로 대체
- 평가지표의 목표값을 전반적으로 **더 도전적**으로 조정
- 3번의 오차 허용 지름은 당분간 **n%** 로 표기(추후 교수님 실측 후 확정)

---

### 최종 평가지표 (수정안)
**평가 지표 정리**

| 구분 | 측정 방법 | 목표 지표 |
|---|---|---|
| **평가지표 1. 움직이는 대상 빠르게 쫓아가기** | 얼굴이 좌우(±1 m), 상하(±50 cm) 중 한 방향으로 **0.5 m/s**(참고: 1 m 이동=2 s)로 이동할 때, 로봇팔이 따라간 뒤 **다시 얼굴을 인식하기까지 걸린 시간** 측정 | **2초 이내** |
| **평가지표 2. 로봇팔 이동간에 흔들림 방지** | 사용자가 **30 cm를 3초(10 cm/s)** 동안 단일 방향으로 이동. 매 프레임 얼굴 중심좌표 $(x_t, y_t)$ 기록 → 연속 프레임 간 **이동 벡터 크기** $d=\sqrt{(\Delta x)^2+(\Delta y)^2}$ 계산 → $d \le 10\,\text{px}$ 인 프레임 **비율** 산출 | **85% 이상** |
| **평가지표 3. 사용자 정지 시 떨림 보정** | 사용자가 **정지 3초** 유지. 첫 좌표를 **기준 좌표**로 설정하고, 기준을 중심으로 **지름 = 화면 가로의 $n\%$** 원을 정의. 모든 프레임 좌표가 **원 내부**에 위치한 **비율** 계산 | **원 내부 비율 $\ge 80\%$** |

---

### 기타 논의사항 / 다음 회의
- 해당 평가지표를 만족하기 위한 방식 찾아서 다음 회의
- 다음 회의 일정은 필요 시 Discord에서 추후 조율
