JJong-03/face-tracking-robot-arm/archive/weekly_notes/2nd_semester/08week.md

# 회의 기록

* 일시: **8주차 (2025-10-25 기준)**
* 장소: 온라인, 오프라인
* 작성자: 김종원

---

## 참석자

* 김종원
* 김동현
* 손홍준
* 최민주

---

## 진행 내용

* **2025-09-28 기준 평가지표(1·2·3) 업데이트 버전과 비교·수정 완료**
* **평가지표 1(FRT)** 측정 **통과 확인 → 이전 회차 패널티 1건 해제**
* **평가지표 2, 3**는 여전히 진동 억제 성능 개선 필요
* 향후 주차에서는 **떨림 보정 알고리즘 및 하드웨어 진동 제어 방식 확정** 예정

---

## 변경 요약

| 구분 | 변경 내용 | 비고 |
| --- | --- | --- |
| **평가지표 1 (FRT)** | - 단순 시간 측정 방식 → **프레임 비율 기반 평가 방식**으로 수정  <br> - 이동 완료 후 **0.2초 구간 내 인식 프레임 비율 ≥ 80%** 기준 신설 <br> - **총 5회 측정 중 4회 이상 성공 시 통과**로 변경 <br> - 실험 환경 및 측정 절차 상세화 (거리·기준점·이동 방향·타이머 사용 등) | 측정 방식 세분화 및 판정 기준 명확화 |
| **평가지표 2 (IFR10)** | - 이동 거리 **±30 cm**, 이동 시간 **3초 이내**로 변경  <br> - 평가 기준 **10px → 20px 이하** 프레임 비율 ≥ 80%로 완화 <br> - 실험 환경(거리 측정, 우드락 표시목 설치 등) 명시 <br> - **코드 안내문("움직임 시작") 출력 시 이동 시작**으로 절차 표준화 | 저속 구간 안정성 중심으로 측정 기준 조정 |
| **평가지표 3 (ICR3)**  | - 정지 전 이동 조건: **±30 cm, 3초 이동 후 3초 정지 유지**로 변경 <br> - **“정지 시작” 문구 출력 → 정지 상태 3초 계측** 절차 추가 <br> - 원의 크기 기준: 화면 가로 해상도의 **n% 반지름** 명시 <br> - **계측·분석 절차**(좌표 기록, 원 내부 비율 계산) 구체화 | 정지 안정성 구간 측정 방식 구체화 |

---

## 결과 및 피드백

* **평가지표 1 (FRT)**
  → 코드 수정 후 측정 **정상 통과**, 판정 기준 충족으로 **이전 회차 패널티 해제**
* **평가지표 2 (IFR10)**
  → 프레임 간 이동 벡터 계산 정상 작동,
  하지만 일부 구간에서 미세 떨림 지속 → **보정 알고리즘 추가 필요**
* **평가지표 3 (ICR3)**
  → 정지 구간 내 잔떨림 존재 → **서보모터 진동 보정 및 하드웨어 감속 제어** 검토 중

---

## 향후 계획

* **평가지표 2~3 개선 방향 결정**

  * 소프트웨어적으로: PID/Moving Average 기반 **미세 떨림 보정 알고리즘** 적용
  * 하드웨어적으로: **디지털 서보모터 + 고토크 모델 교체** 검토
* **다음 회의(2025-11-01 예정)**에서 떨림 제어 방법 최종 확정 및 재측정 일정 조율
  * 또한, 평가지표 3번의 n% 기재를 교수님과 상담 이후에 픽스할 예정.
---

> **요약:**
>
> * 평가지표 1 통과로 패널티 1건 해제 완료
> * 평가지표 2·3의 진동 억제를 위해 **소프트웨어+하드웨어 통합 보정 전략** 수립 예정
> * 모든 수정 내용 및 측정 코드는 GitHub 저장소에 업데이트 완료
