JJong-03/face-tracking-robot-arm/archive/weekly_notes/2nd_semester/05week.md

# 회의 기록

* 일시: **5주차 (2025-09-29 ~ 2025-10-05)**
* 장소: 온라인, 오프라인
* 작성자: 김종원

## 참석자

* 김종원
* 김동현
* 손홍준
* 최민주

---

## 진행 내용

* 지난주 확정된 **정량지표 3종(FRT, IFR10, ICR3)** 을 기반으로 본격적인 측정 진행
* 이번 주차 **평가지표 2(IFR10)** 만 정상적으로 측정 완료
* **평가지표 1(FRT)** 과 **3(ICR3)** 는 환경적 요인으로 측정 실패 → **10월 15일 재측정 예정**
* 측정 과정 중 발생한 진동 및 추적 지연 문제로 **코드 수정 및 하드웨어 개선 작업 병행 중**

---

## 논의 내용

* **평가지표 1 (FRT)**: 측정 환경(조도, 거리 변화)에 따라 **얼굴 재인식이 지연**되는 문제 발생 → 카메라 노이즈 필터 및 ROI 보정 코드 개선 중
* **평가지표 2 (IFR10)**: 정상적으로 **데이터 수집 및 결과 산출 완료**, 벡터 크기 10 px 이하 비율 약 **88% 달성**
* **평가지표 3 (ICR3)**: 정지 후 로봇팔 진동 잔류로 인해 **원 내부 비율 60% 수준** → 하드웨어 보완 필요
* 소프트웨어적으로 흔들림 보정을 적용해도, **모터 토크 부족으로 하드웨어 떨림이 존재**함 확인
* **고토크 서보모터 구매 및 교체 예정**, 이후에도 부족할 경우
  → **모터 수를 6개 → 4~5개로 축소**
  → **짐벌(gimbal) 결합형 구조**로 변경 검토

---

## 최종 평가지표 (유지안)

| 구분 | 측정 방법 | 목표 지표 |
| --- | --- | --- |
| **평가지표 1. 얼굴 재인식 시간 (FRT)** | 얼굴이 **수평(±1.0 m)**, **수직(±0.50 m)**, **대각선(↖↘, ↗↙, 경로 길이 ±0.70 m)** 중 한 방향으로 **0.5 m/s** 등속 이동. 로봇팔이 추종하며 **이동 시작(또는 최초 미검출) → 재인식 첫 프레임**까지의 시간을 측정 | **≤ 2초** |
| **평가지표 2. 로봇팔 저속 추적 안정성 (IFR10)** | 사용자가 **30 cm를 3 s(10 cm/s)** 동안 단일 방향으로 이동. 매 프레임 얼굴 중심 ((x_t,y_t)) 기록 → 연속 프레임 벡터 (d_t=\sqrt{(\Delta x)^2+(\Delta y)^2}) 계산 → (d_t \le 10) px 프레임 비율 산출 | **≥ 85%**<br>IFR10 목표 수치 예시 |
| **평가지표 3. 정지 고정 안정성 (ICR3)** | (**정지 전**) 사용자 **30 cm·3 s(10 cm/s)** 이동 → (**정지 구간**) **3 s 정지**. 첫 좌표를 기준으로 **지름 = 프레임 가로의 3%**인 원을 그리고, 정지 구간 프레임들의 **원 내부 비율** 계산 | **원 내부 비율 ≥ 80%**<br>ICR3 목표 수치 예시 |

---

## 기타 논의사항

* **코드 로깅 포맷**(방향, 해상도, FPS, 반복 횟수, 실패 기준)을 통일하여 QA 자동화 스크립트에 반영 예정
* **서보모터 교체 후 테스트 데이터**를 기반으로, 다음 회의에서 구조 변경(모터 수·짐벌 여부) 최종 결정

---

## 다음 회의

* **일정:** 2025-10-08 (수) 예정
* **내용:** 코드 및 하드웨어 개선 결과 공유, 재측정 준비 진행
* **장소:** Discord (공지 후 참여)
