JJong-03/face-tracking-robot-arm/archive/weekly_notes/2nd_semester/07week.md

# 회의 기록

* 일시: **7주차 (2025-10-13 ~ 2025-10-19)**
* 장소: 온라인, 오프라인
* 작성자: 김종원

## 참석자

* 김종원
* 김동현
* 손홍준
* 최민주

---

## 진행 내용

* **평가지표 1·2·3 측정 결과 시연 및 발표 진행**
* 모든 평가지표(재인식, 추적 안정성, 정지 안정성)에 대해 **측정 통과 판정** 받음
* 교수님 피드백:

  * **모터 수를 줄이는 방향**이 떨림 제어 및 안정성 향상에 효과적일 것으로 보임
* 이후 계획:

  * **모터 수를 축소(6개 → 4~5개)** 하여 하드웨어 구조 개선
  * 코드 내 **모터 제어 알고리즘 수정** 및 **진동 보정 로직 강화** 예정
* **평가지표 측정용 코드 전면 정리 및 GitHub 업로드 완료**

---

## 논의 내용

* **평가지표 측정 통과 보고**

  * **평가지표 1 (FRT)** : 얼굴 재인식 시간 ≤ 2초로 안정적 통과
  * **평가지표 2 (IFR10)** : 평균 50% 정도의 정확도가 나오며, 기준 미충족
  * **평가지표 3 (ICR3)** : 또한, 평균 50% 정도의 정확도가 나오며, 현재 기준 미충족
  
* **피드백 반영 방향**
  * 서보모터의 떨림을 제거하기 위해, 기존 아날로그 서보모터를 디지털 서보모터로 교체 검토 중
  * 동시에 더 높은 토크(출력)의 서보모터로 변경하여 하드웨어 안정성 향상 목표
  * 기존 6모터 구조는 유지하되, 교체 후 모터 간 제어 지연·과도 응답 개선 여부 확인 예정

---

## 최종 평가지표 (유지)

| 구분 | 측정 방법 | 목표 지표 |
| --- | --- | --- |
| **평가지표 1. 얼굴 재인식 시간 (FRT)** | 얼굴이 수평(±1.0 m), 수직(±0.50 m), 대각선(±0.70 m) 중 한 방향으로 **0.5 m/s** 등속 이동 시, 로봇팔이 따라간 뒤 다시 얼굴이 인식되기까지의 시간 측정 | **≤ 2초** |
| **평가지표 2. 로봇팔 저속 추적 안정성 (IFR10)** | 사용자가 **30 cm를 3 s(10 cm/s)** 동안 단일 방향으로 이동. 매 프레임 얼굴 중심 ((x_t,y_t)) 기록 → 연속 프레임 벡터 (d_t=\sqrt{(\Delta x)^2+(\Delta y)^2}) 계산 → (d_t \le 10) px 프레임 비율 산출 | **≥ 85%** |
| **평가지표 3. 정지 고정 안정성 (ICR3)** | (**정지 전**) 사용자 **30 cm·3 s(10 cm/s)** 이동 → (**정지 구간**) **3 s 정지**. 첫 좌표를 기준으로 **지름 = 프레임 가로의 3%**인 원을 그리고, 정지 구간 프레임들의 **원 내부 비율** 계산 | **원 내부 비율 ≥ 80%** |

---

## 기타 논의사항

* **하드웨어 진동 제어 강화**를 위해 모터 수 축소 실험 진행
* 평가지표 관련 코드 GitHub에 업로드 완료
* 추후 모터 구조 변경 시 **새 명령 프로토콜 및 제어 코드 재작성 예정**

---

## 다음 회의

* **일정:** 2025-10-20 (월) 예정
* **내용:** 평가지표 1 (FRT) 통과 결과 발표 준비 및 시연 영상 점검
* **장소:** Discord
