JJong-03/face-tracking-robot-arm/assets/images/hardware/1st_semester/1stSem_hardware_initial-robot-arm.png

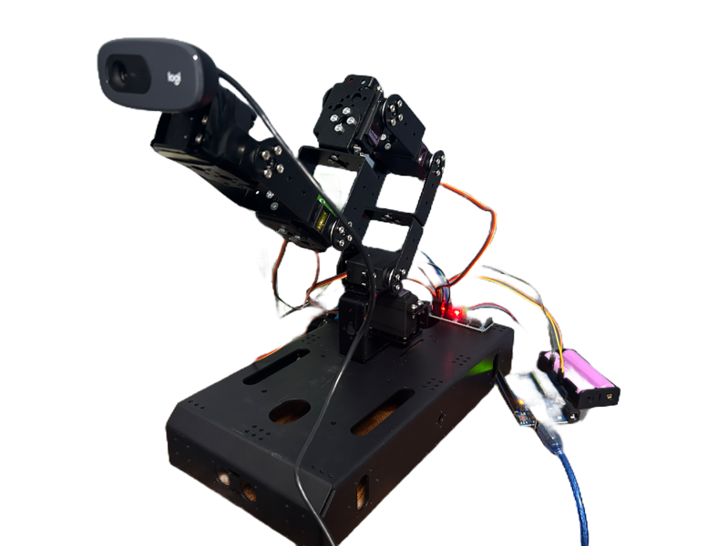
assets/images/hardware/1st_semester/1stSem_hardware_initial-robot-arm.png
