JJong-03/face-tracking-robot-arm/assets/images/hardware/2nd_semester/06_hardware-change_motor-upgrade.png

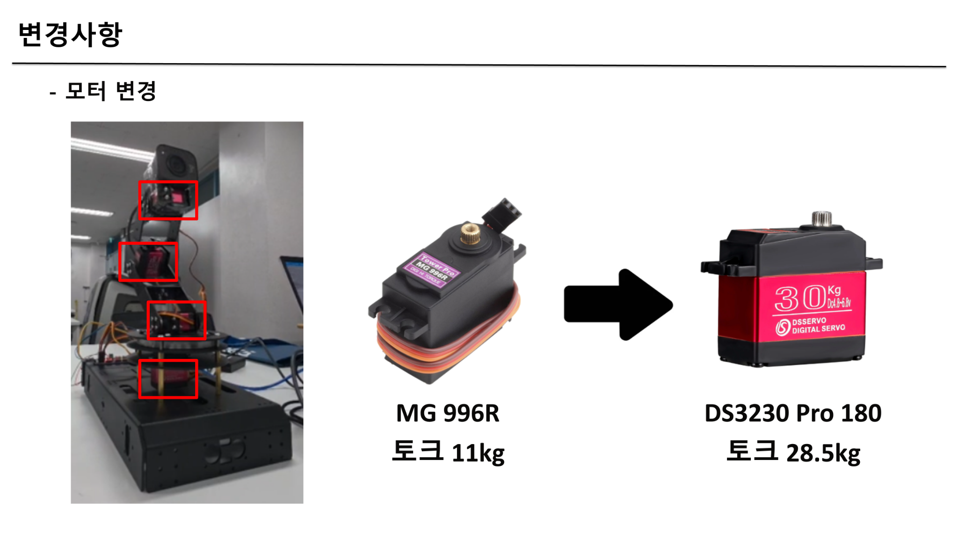
assets/images/hardware/2nd_semester/06_hardware-change_motor-upgrade.png
