JJong-03/face-tracking-robot-arm/assets/images/hardware/2nd_semester/07_hardware-change_gimbal-added.png

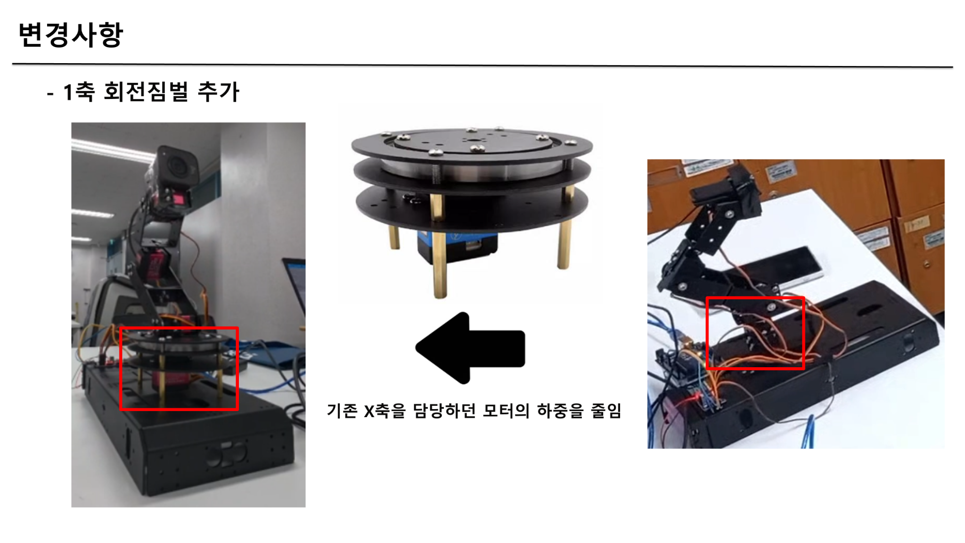
assets/images/hardware/2nd_semester/07_hardware-change_gimbal-added.png
