JJong-03/face-tracking-robot-arm/assets/images/hardware/2nd_semester/08_hardware-change_camera-upgrade.png

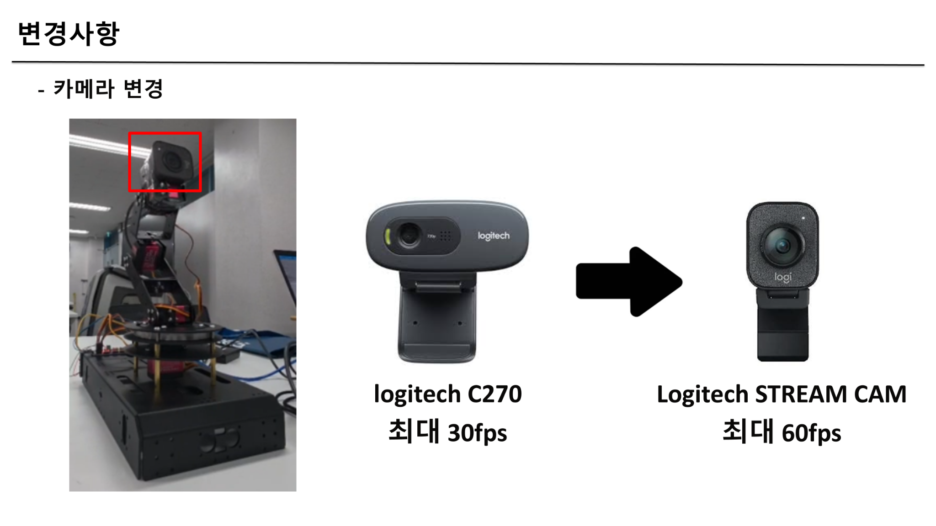
assets/images/hardware/2nd_semester/08_hardware-change_camera-upgrade.png
