JJong-03/face-tracking-robot-arm/assets/images/hardware/2nd_semester/09_hardware-change_fps-improvement.png

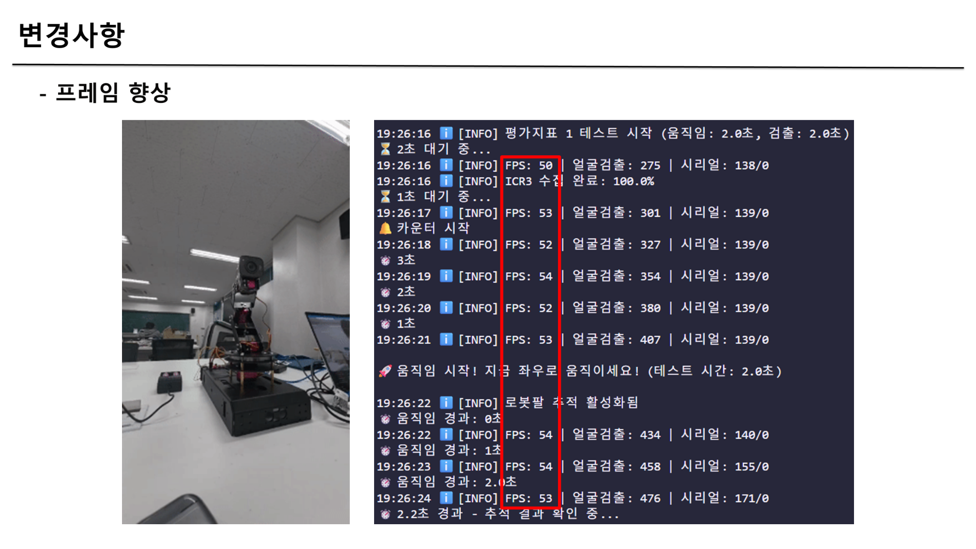
assets/images/hardware/2nd_semester/09_hardware-change_fps-improvement.png
