JJong-03/face-tracking-robot-arm/assets/images/metrics/metric1_frt_detailed-method.png

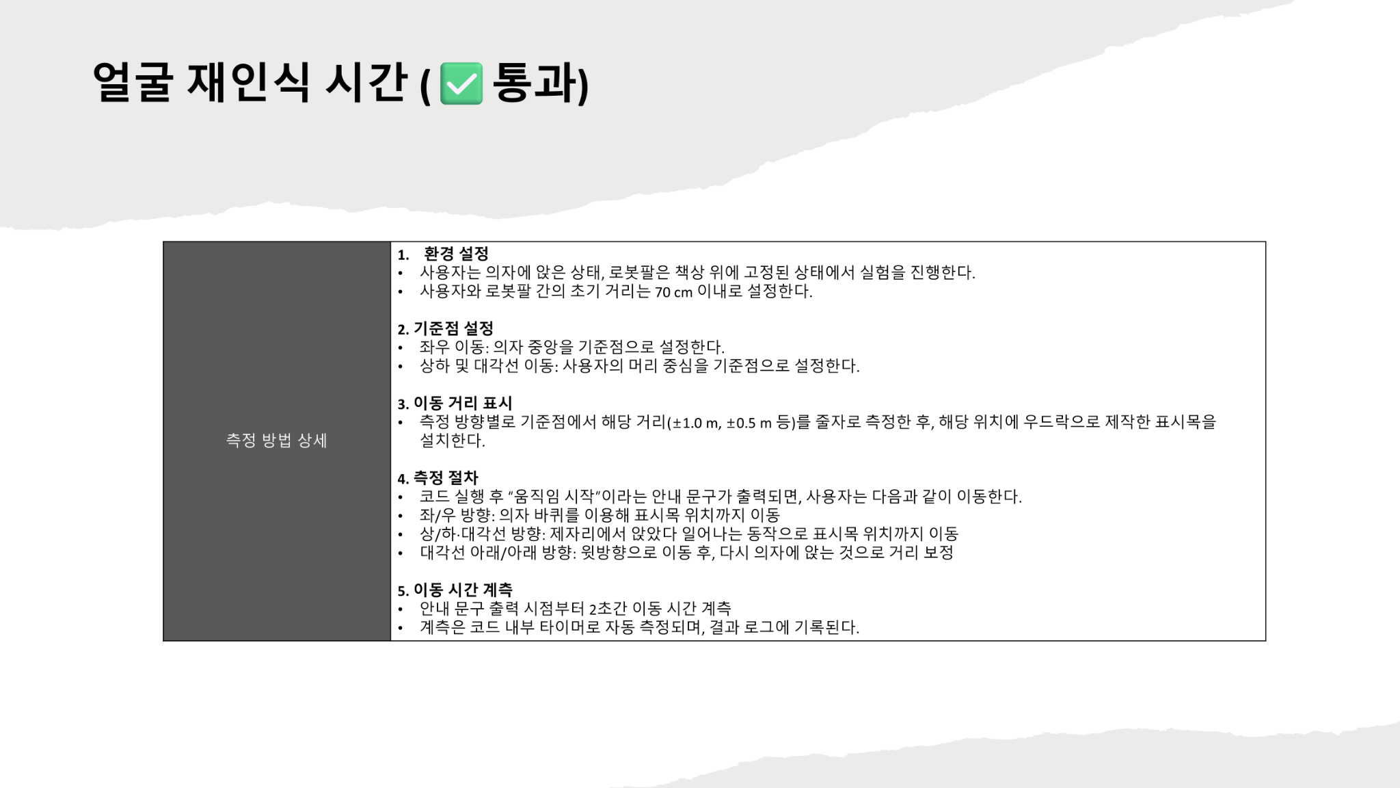
assets/images/metrics/metric1_frt_detailed-method.png
