JJong-03/face-tracking-robot-arm/assets/images/metrics/metric2_ifr_detailed-method.png

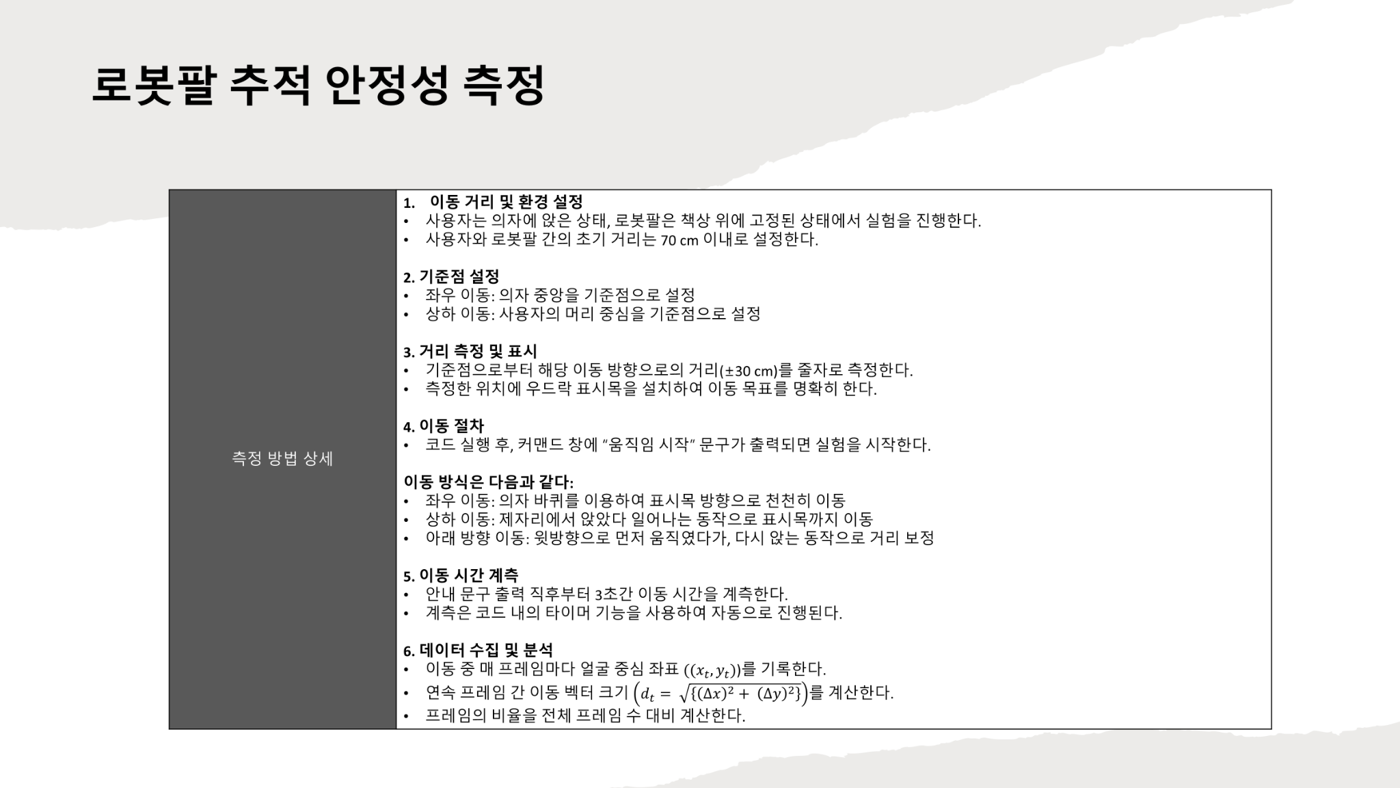
assets/images/metrics/metric2_ifr_detailed-method.png
