JJong-03/face-tracking-robot-arm/assets/images/metrics/metric3_icr_detailed-method.png

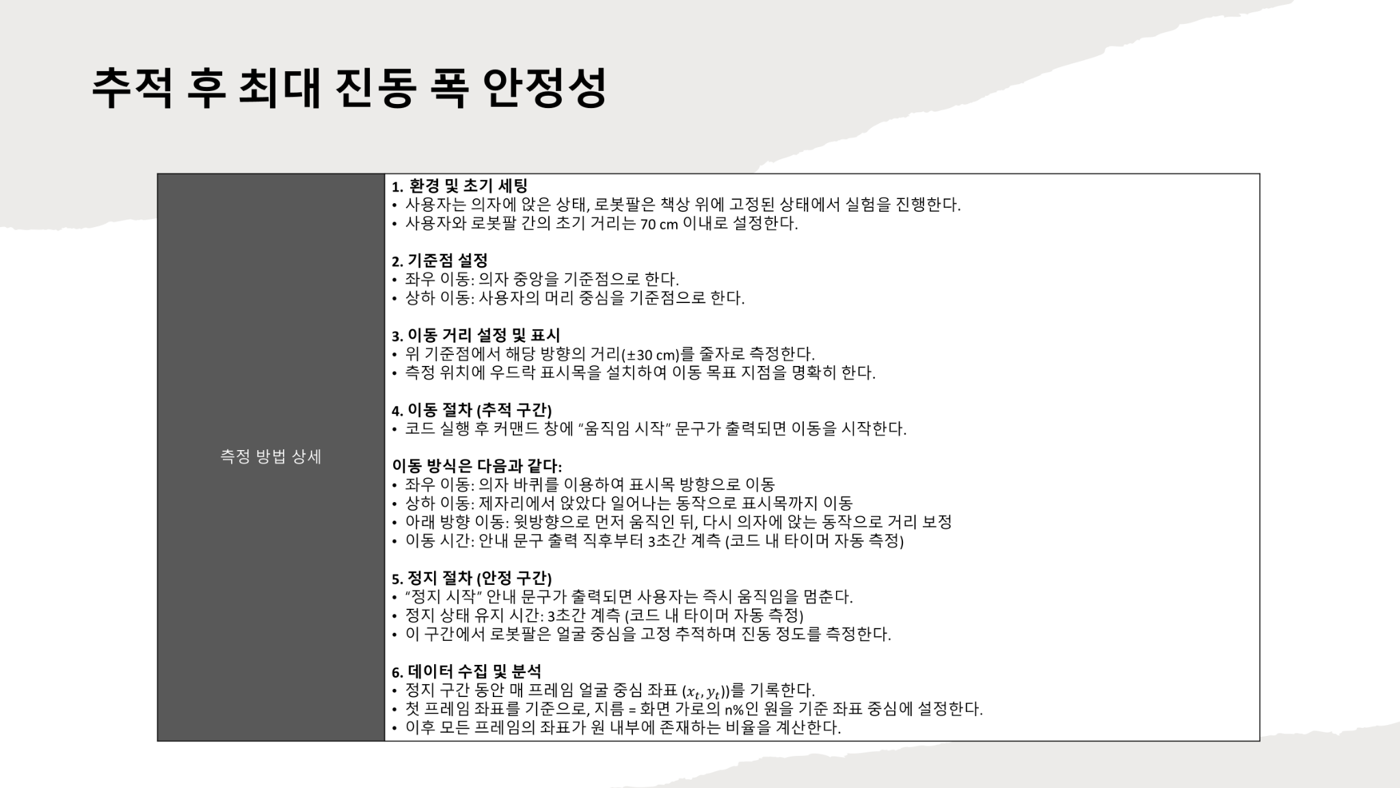
assets/images/metrics/metric3_icr_detailed-method.png
