JJong-03/face-tracking-robot-arm/assets/images/poster/1stSem_capstone-panel.jpg

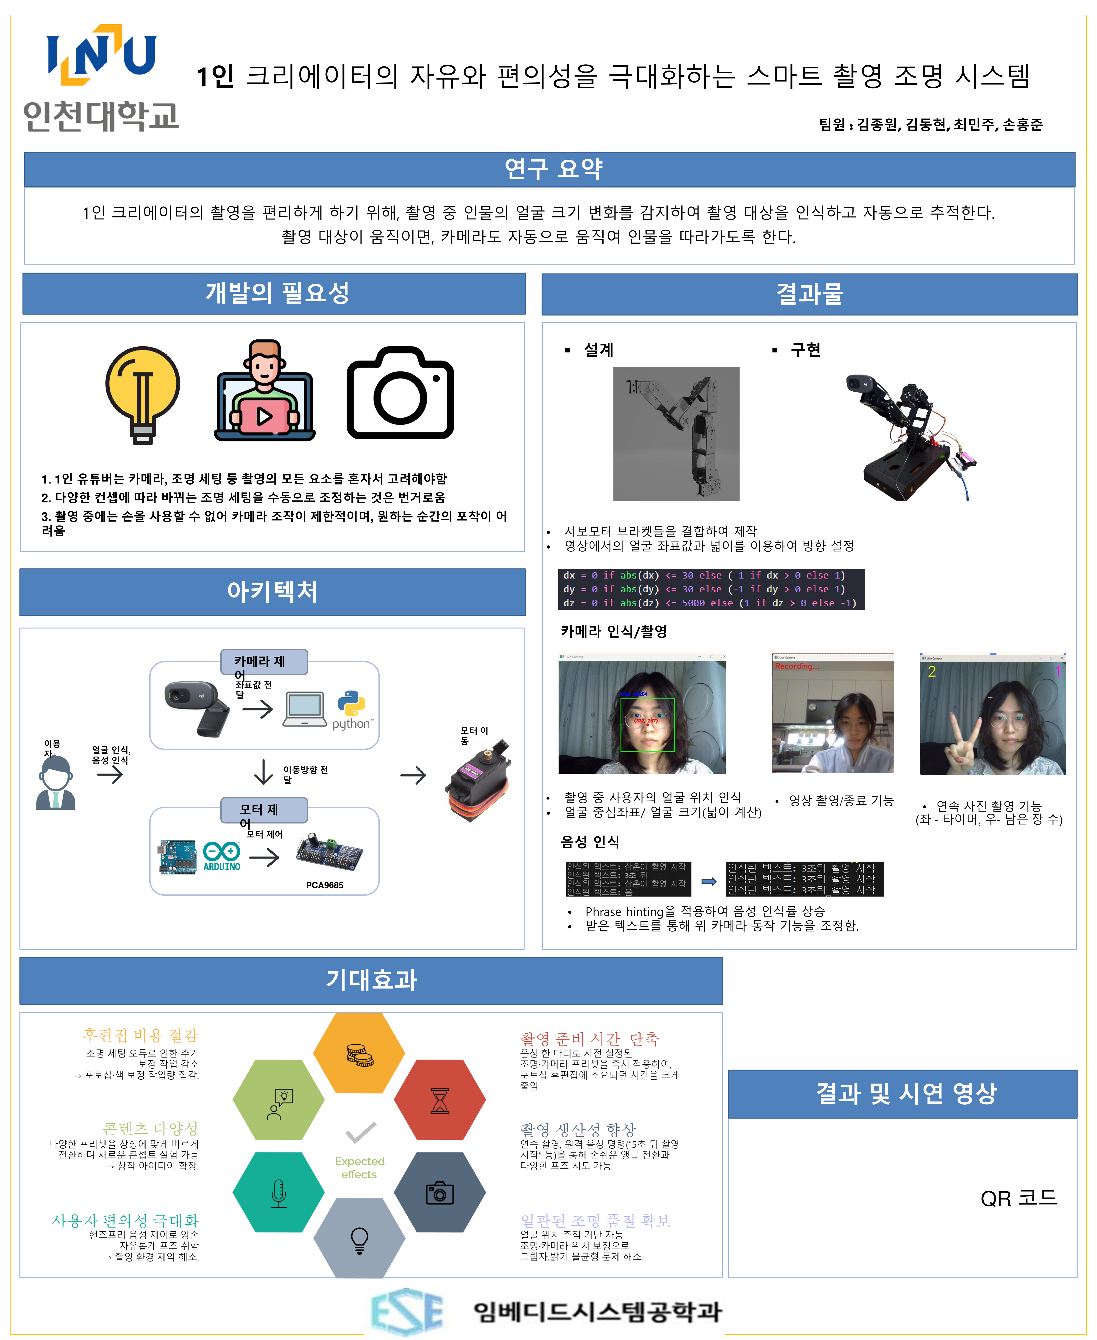
assets/images/poster/1stSem_capstone-panel.jpg
