JJong-03/face-tracking-robot-arm/assets/images/poster/final_capstone-panel.jpg

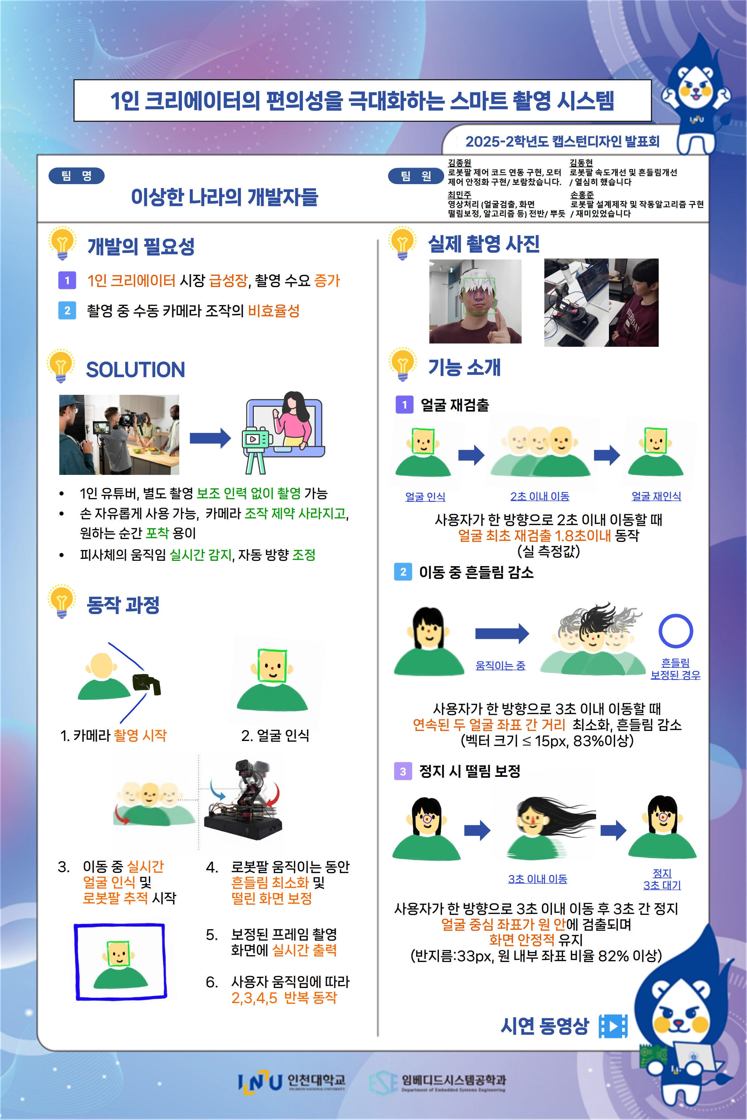
assets/images/poster/final_capstone-panel.jpg
