JJong-03/face-tracking-robot-arm/assets/references/award_certificate/2025_info-tech-college-dean-encouragement-award.jpg

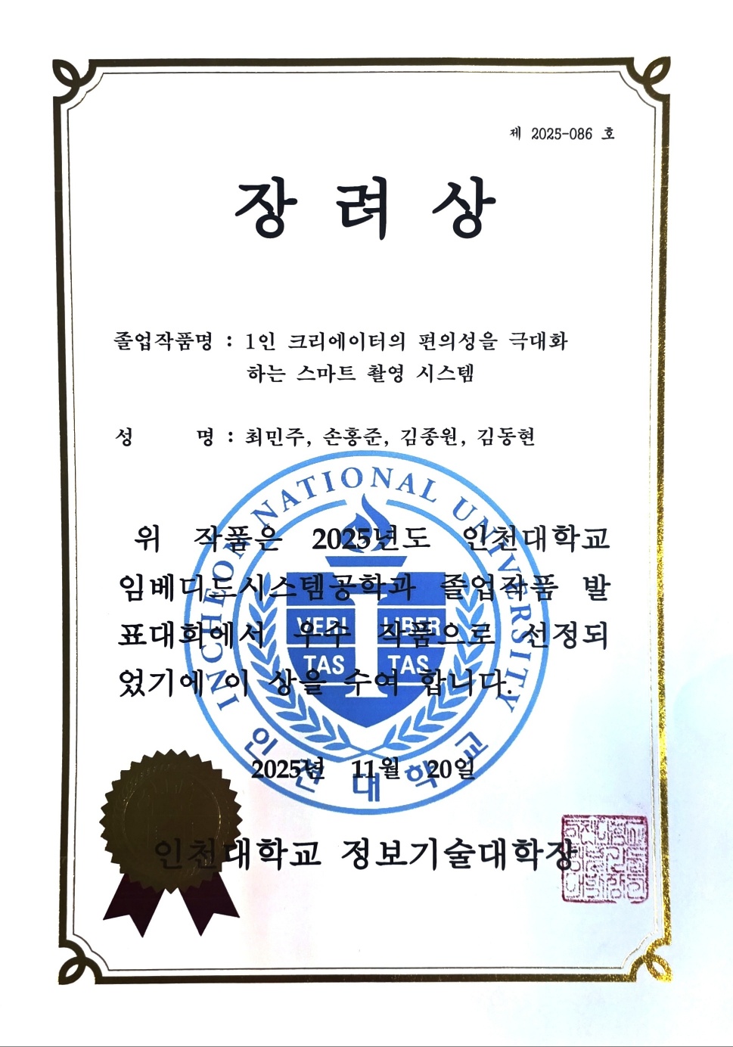
assets/references/award_certificate/2025_info-tech-college-dean-encouragement-award.jpg
