JJong-03/face-tracking-robot-arm/assets/presentations/phase1/20250506_1stSem_10week_presentation_voiceModuleTest.pptx

Team.

이상한 나라의 개발자

2025.05.08

김종원 김동현 손홍준 최민주

## Slide 2

01 상세 기능
02 음성처리 확인
03 이후 계획

Contents

## Slide 3

01 상세기능

이용자 위치에 따른 카메라 이동

- 음성 명령을 통한 촬영 제어
- 타이머를 통한 촬영
- N장 연속 촬영


음성 명령

조명 밝기 조절

- 단계별 조명 밝기 제어

카메라 조정

- 얼굴 화면 중앙 유지

로봇팔 제작

- 사용자의 움직임에 맞게 회전 및 이동

## Slide 4

01 상세기능

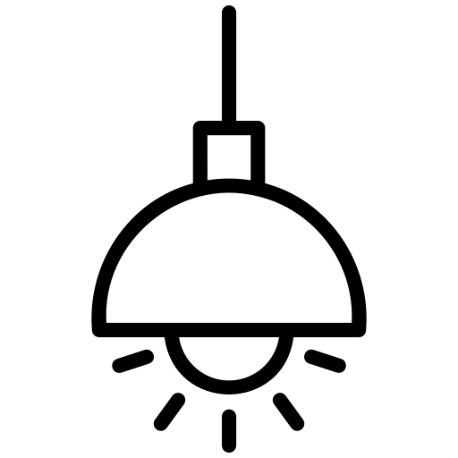
[picture p85: figure]
블랙, 어둠이(가) 표시된 사진 AI가 생성한 콘텐츠는 부정확할 수 있습니다.

음성 명령에 따른 조명, 카메라 조정

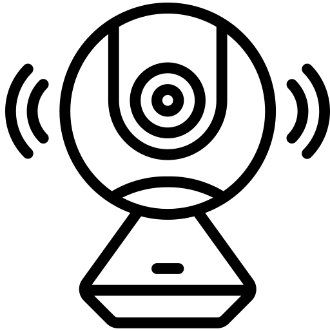
[picture p86: figure]

사용자의 명령에 따라
1. 조명의 밝기를 1~ 5단계로 조절.
2. 영상 촬영 시작, 종료, 사진 촬영을 진행.

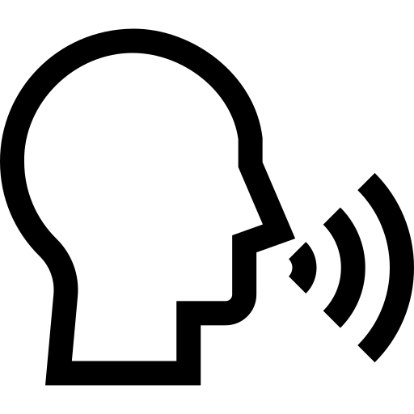
[picture p87: figure]
블랙, 어둠이(가) 표시된 사진 AI가 생성한 콘텐츠는 부정확할 수 있습니다.

Notes: 오늘은 음성 명령을 어떻게 받아왔고 결과를 보여주며 이후에 계획에 대해서 설명드리겠습니다.

## Slide 5

02 음성 처리 확인

2초로 고정하여 음성을 받는 방식

음성이 잘리는 문제가 발생

3~4초로 늘리고, single_utterance=True 변경

오히려 뒤에 말까지 한번에 인식하는 문제 발생.
“말이 끝났다”고 판단을 잘못하여 긴 문장은 못 가져오는 문제

Notes: “처음에는 PyAudio로 2초 고정 녹음한 뒤 Google STT recognize()를 호출하는 방식을 사용했습니다.”
“예를 들어 ‘영상 촬영 시작’을 말하면, 2초 안에 들어온 부분만 인식해서… 영상 촬영만, 혹은 시작만 출력되는 현상이 자주 발생했습니다.”

“이후에 녹음 시간을 3~4초로 늘리고, single_utterance=True 옵션을 적용해 ‘한 번의 말이 끝나면 즉시 결과를 반환’하도록 변경했지만,
무음 감지 기준이 엄격하거나 너무 느슨하게 작동해 여전히 긴 문장이 중간에 잘리거나 음절 일부만 반환되는 문제가 발생했습니다.
예를 들어 ‘5초 뒤에 영상 촬영 시작’을 말해도 ‘영상 촬영’만, 또는 ‘시작’만 인식되는 경우가 많았습니다.”

## Slide 6

02 음성 처리 확인 (최종 선택)

VAD(Voice Activity Detextion) 사용

고정된 녹음 시간을 기다릴 필요 x
=> 음성 활동 구간만 골라낸다.

Phrase Hinting 기능 추가

잡음이 섞이거나 발음이 뭉개지는 상황에서도
더욱 안정적으로 진행

Notes: “그래서 저희는 Google STT의 스트리밍 방식 대신, webrtcvad 기반의 VAD(Voice Activity Detection)를 도입했습니다.
VAD가 ‘음성 활동 구간’만 골라내어 프레임 단위로 묶어 주기 때문에, 말이 시작되고 끝나는 지점을 더 정확하게 잡을 수 있었습니다.
덕분에 2초나 4초처럼 임의로 고정된 녹음 시간을 기다릴 필요 없이, 실제 발화가 끝나는 즉시 오디오 조각을 STT에 전달할 수 있었죠.
결과적으로 “5초 뒤에 영상 촬영 시작” 같은 긴 명령어도 음절 하나하나 끊기지 않고 통째로 인식되었고,
‘영상 촬영 시작’과 ‘영상 촬영 종료’, ‘1단계’~‘5단계’ 같은 키워드 매칭도 훨씬 안정적으로 동작하게 되었습니다.

또한, 음성 인식의 정확도를 높이기 위해 Phrase Hinting 기능을 도입했습니다.
Phrase Hinting은 자주 쓰는 명령어를 미리 등록하고, 각 문구에 boost라는 가중치를 부여하여
STT 엔진이 유사 표현보다 등록된 키워드를 우선적으로 인식하도록 돕는 방법입니다.
저희는 “영상 촬영 시작”, “1단계” 등 주요 명령어들을 리스트에 등록하고,
명령어별 사용 빈도, 그리고 단어의 길이에 따라 적절한 boost 값을 설정했습니다.
그 결과, 발음이 흐려지더라도
필요한 키워드가 빠지지 않고 안정적으로 인식되도록 보완할 수 있었습니다.

## Slide 7

02 음성 처리 확인

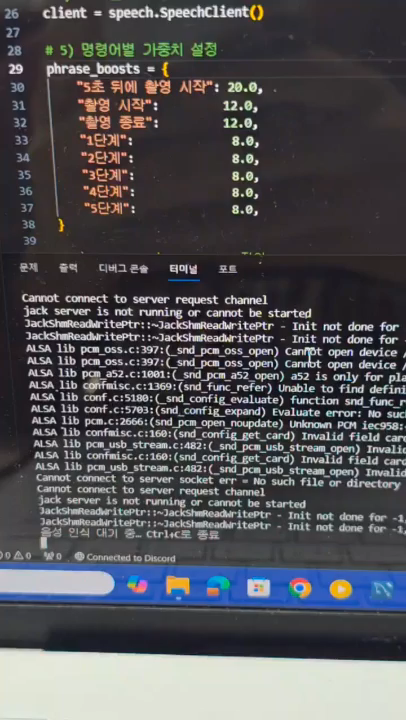
[picture p88: figure]

진행 영상

## Slide 8

03 이후 계획

1. 다음주까지 받아온 음성에 대해 카메라 동작 및 조명 동작 진행.
2. 추가적으로 유용한 음성 기능이 있다면 해당 기능을 추가하는 것.
