JJong-03/face-tracking-robot-arm/assets/images/metrics/11_metric3_result-screen_and-terminal.png

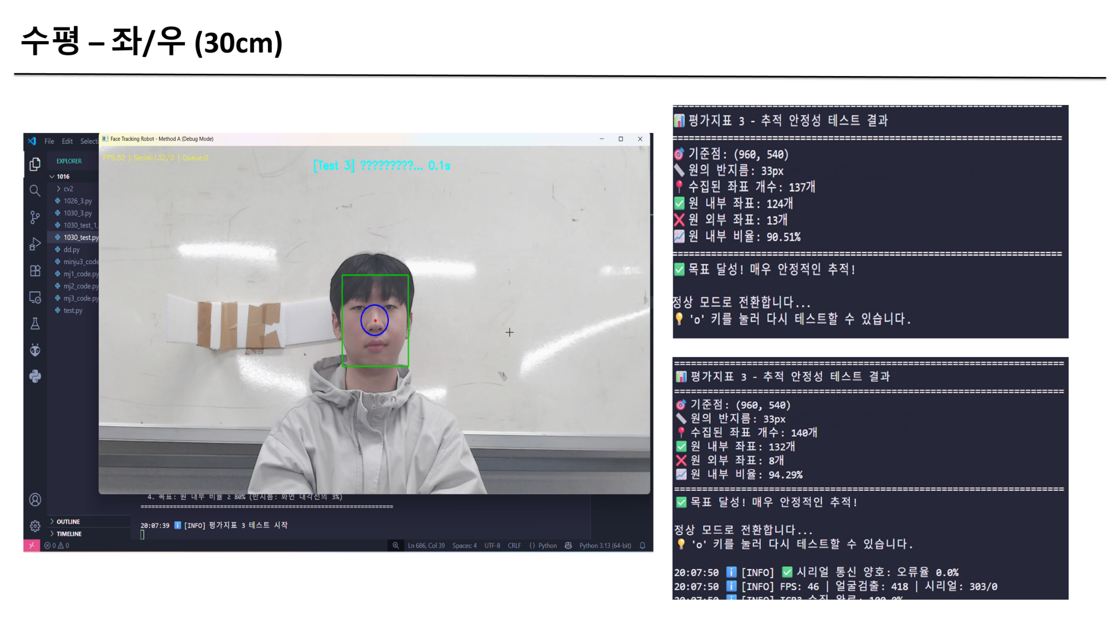
assets/images/metrics/11_metric3_result-screen_and-terminal.png
